sire234/VatPoeToUsb/datasheets/Ag9900_V3.5_2026-03_LPB_SUMMARY.md

# Ag9905-LPB — Silvertel Ag9900-Familie, PoE-PD-Modul 5 V, Low-Profile-SMT (U1)

Quelle: Silvertel Ag9900 Datenblatt **V3.5 (März 2026)**, `Ag9900_V3.5_2026-03_LPB.pdf` (silvertel.com; Text gelesen 2026-10-23). Abbildungs-/Tabellennummern beziehen sich auf V3.5.

| Spec | Wert |
|---|---|
| Norm / Klasse | IEEE 802.3af, Signatur im Modul, **Class 0** (0,44 … 12,95 W) |
| Eingang | 36 … 57 V (typ 48 V); Anlauf ≥ 42 V; UVLO 30 … 36 V; abs. max 60 V, Surge 80 V / 1 ms |
| Ausgang | **5,00 V (4,75 … 5,25 V)**, I_out max **1,4 A** (LP/LPB) |
| Leistung | 7 W; Industrial-Derating **4,5 W @ 85 °C** (Tab. 1, Fig. 10 „LP(B) Operating Profile") |
| Mindestlast | **200 mA** (§2.3.3, §9.3); darunter hörbares Geräusch, MPS-Risiko |
| Regelung | Line 0,01 %, Load 0,08 % |
| Ripple | 120 mVpp (mit Filter A) |
| Wirkungsgrad | 83 % Peak |
| Isolation | **1500 V Impulstest (V_PK)** (§6); Leiterbahnen beidseits der Barriere ≥ 3 mm |
| Temperatur | Industrial −40 … +85 °C, Thermoschutz (reduziert Leistung) |
| Gehäuse LPB (Fig. 18) | 21,21 (max 22,21) × 13,92 (max 14,92) mm, Höhe **8,00 (max 9,20)**; Freihaltung J×K×L 22,81 × 15,52 × 9,20 mm |
| Löten | Reflow J-STD-020, **MSL 1**, **nur Oberseite** (nicht kopfüber durch den Reflow, §8); SMD-Pads (soldermask-defined) bevorzugt |

## Pinout LPB (Tab. 2, 5 Pads)
| Pin | Name | Projekt-Netz |
|-----|---|---|
| 1 | +VDC | +5V_RAW |
| 2 | −VDC | GND |
| 3 | ADJ | AG_ADJ (offen = 5,00 V) |
| 4 | VIN+ | VDD_POE |
| 5 | VIN− | VSS |

(Zum Vergleich LP/DIL, Tab. 3: 1,2 +VDC · 3 −VDC · 4 ADJ · 5,6 VIN+ · 7,8 VIN− – **nicht** pinkompatibel.)

## Externe Beschaltung (Fig. 5, 14, 16)
- BR1/BR2 z. B. MB4S/MB6S → D1/D2 MB6S.
- TVS **SMAJ58A** über VIN (Fig. 14) → D3.
- C1 100 µF low-ESR + C2 10 µF 25 V am Ausgang → C11 100 µF Polymer + C12 22 µF.
- RB ≥ I_load,min (Option) → R8 DNP.
- EMV (Fig. 16): 2 × 4,7 nF / 2 kV Ein-/Ausgang → im Projekt nur C14 2,2 nF Y2 als DNP-Option.
- ADJ (Tab. 4): R ADJ→+VDC senkt (0 Ω → 4,48 V), R ADJ→−VDC hebt (0 Ω → 5,65 V) → R9 DNP nach GND.

## Thermik (§3)
Kupferflächen an +VDC/−VDC auf beiden Aussenlagen mit vielen Vias (Fig. 12); optional Wärmeleitgel > 1,5 W/m·K unter dem Modul (Fig. 13). VIN-Seite nicht an Sekundärkupfer koppeln.

## Land Pattern
Fig. 21 (Reflow, im Projekt verwendet: `Silvertel_Ag9900LPB_SMD`), Fig. 22 (Handlöten: `Silvertel_Ag9900LPB_SMD_HandSolder`), jeweils mit Isolations-Keepout.
