sire234/VatPoeToUsb/datasheets/BLM18PG121SN1D_SUMMARY.md

# BLM18PG121SN1D — Murata Ferrit-Chip-Bead 120 Ω @ 100 MHz, 0603 (FB2)

Quelle: Murata-Katalog Chip-Ferrite-Beads (BLM-Serie), `BLM18PG121SN1D.pdf` (LCSC C14709). Der Katalog-Text ist nur teilweise maschinenlesbar; Werte aus Katalogzeile BLM18PG121SN1 und den JLC/LCSC-Attributen (sourced_bom).

| Spec | Wert |
|---|---|
| Impedanz | 120 Ω ±25 % @ 100 MHz |
| Nennstrom | 2 A |
| DCR | max 0,05 Ω |
| Bauform | 0603 (1,6 × 0,8 mm) |

## Pinout
Unpolarisiert; Pin 1 = +3V3, Pin 2 = +3V3A.

## Hinweise
- Filter +3V3 → +3V3A (W5500-AVDD, MagJack-CT), Last ≈ 0,1 A.
