sire234/VatPoeToUsb/datasheets/HCB3216KF-601T30_SUMMARY.md

# HCB3216KF-601T30 — TAI-TECH High-Current Ferrit-Chip-Bead 600 Ohm @100 MHz, 3 A, 1206

Quelle: TAI-TECH HCB3216KF-601T30, `HCB3216KF-601T30.pdf` (Text gelesen).

| Spec | Value |
|---|---|
| Impedanz | 600 Ohm +-25 % @ 100 MHz (60 mV) |
| DC-Widerstand | 0.04 Ohm max |
| Nennstrom | 3000 mA |
| Abmessungen | 3.20 +-0.20 x 1.60 +-0.20 x 1.10 +-0.20 mm |
| Temperatur | -40..+125 C (Datenblatt-Angabe "-40~+125 / -40~+105") |
| Package | 1206 |

## Pinout
Unpolarisiert, 2 Anschluesse.

## Notes
- DCR 40 mOhm: bei 1.4 A: 56 mV Verlust. Bei hohem DC-Strom faellt die Impedanz (Bias-Derating) - Kurve im Datenblatt (Impedance vs. DC-Bias).
