sire234/VatPoeToUsb/datasheets/SA11AM101A19R15XXX_SUMMARY.md

# SA11AM101A19R15XXX — AISHI Polymer-Aluminium-Kondensator 100 µF 10 V, 7343 (C11)

Quelle: AISHI/Aihua Specification A1-Serie (GRS-DC-1710040, 2017-10-26), `SA11AM101A19R15XXX.pdf` (LCSC C135491, Text gelesen 2026-10-23).

| Spec | Wert |
|---|---|
| Kapazität | 100 µF ±20 % |
| Nennspannung / Surge | 10 V / 11,5 V |
| ESR | max **15 mΩ** (100 kHz) |
| Ripple-Strom | **2500 mA rms** (100 kHz, 20 … 105 °C) |
| Leckstrom | max 200 µA |
| D.F. | max 6 % |
| Temperatur | −55 … +105 °C, Lebensdauer 2000 h @ 105 °C |
| Abmessungen | **7,3 × 4,3 × 1,9 mm** (bestätigt die bisher „unverifizierte" Höhe) |

## Pinout
Gepolt: Pin 1 = + → +5V_RAW, Pin 2 = − → GND. Footprint `Capacitor_Tantalum_SMD:CP_EIA-7343-31_Kemet-D`.

## Hinweise
- Erfüllt die Ag9900-Pflicht „≥ 100 µF low-ESR am Ausgang" (DS V3.5 §2.1), auch bei Kälte.
- Ripple-Rating 2,5 A ≫ Modulausgang 1,4 A.
