sire234/VatPoeToUsb/mechanical/gehaeuse_eckig_rev1/ansicht_druckplatte.png

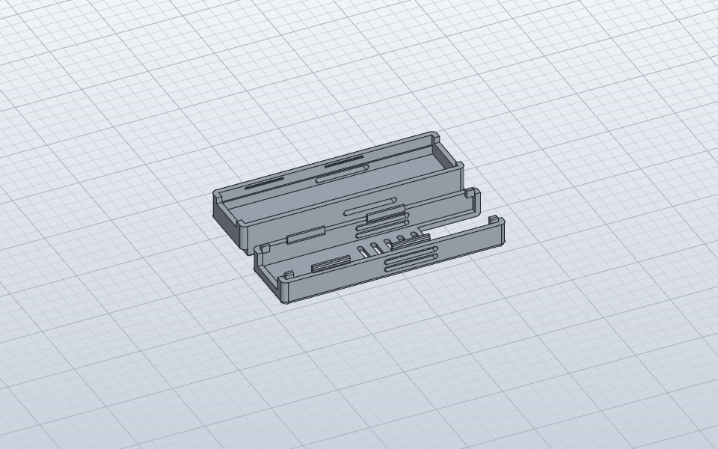
mechanical/gehaeuse_eckig_rev1/ansicht_druckplatte.png
