sire234/VatPoeToUsb/mechanical/gehaeuse_eckig_rev1/ansicht_innen.png

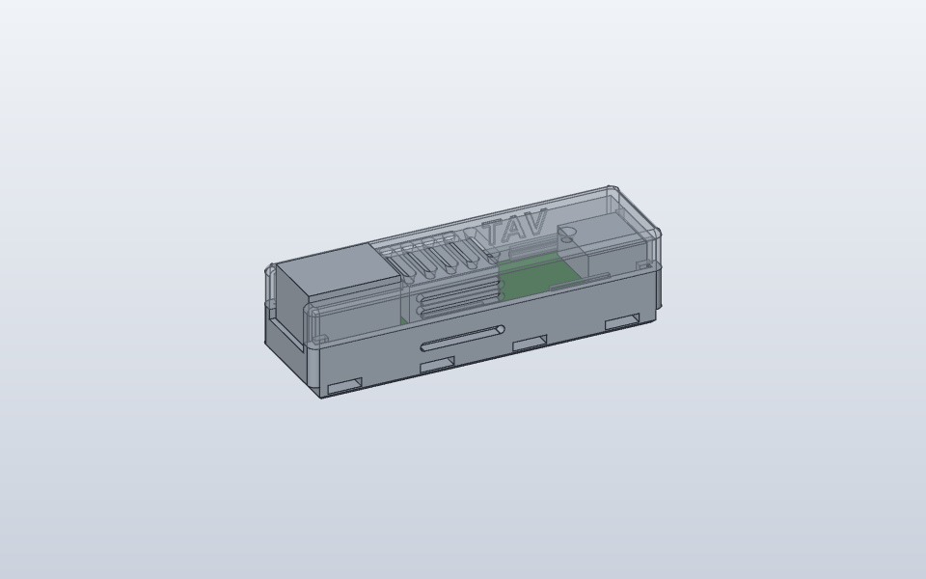
mechanical/gehaeuse_eckig_rev1/ansicht_innen.png
