sire234/VatPoeToUsb/mechanical/gehaeuse_eckig_rev1/ansicht_unten.png

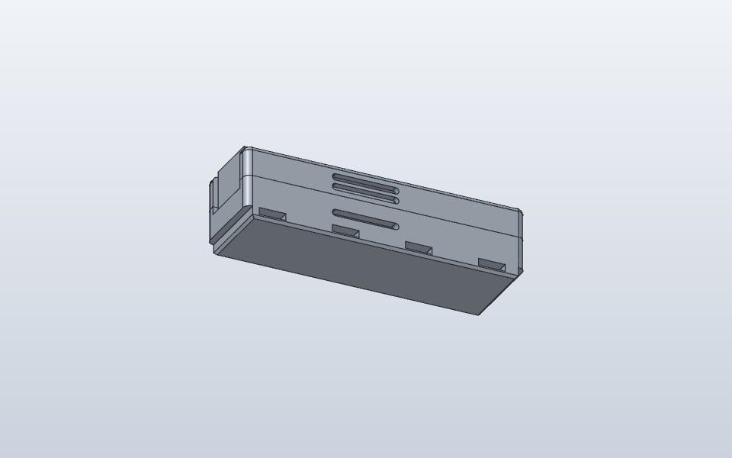
mechanical/gehaeuse_eckig_rev1/ansicht_unten.png
