sire234/VatPoeToUsb/outputs/layout_rev4g/detail_bottom_R5_R6.png

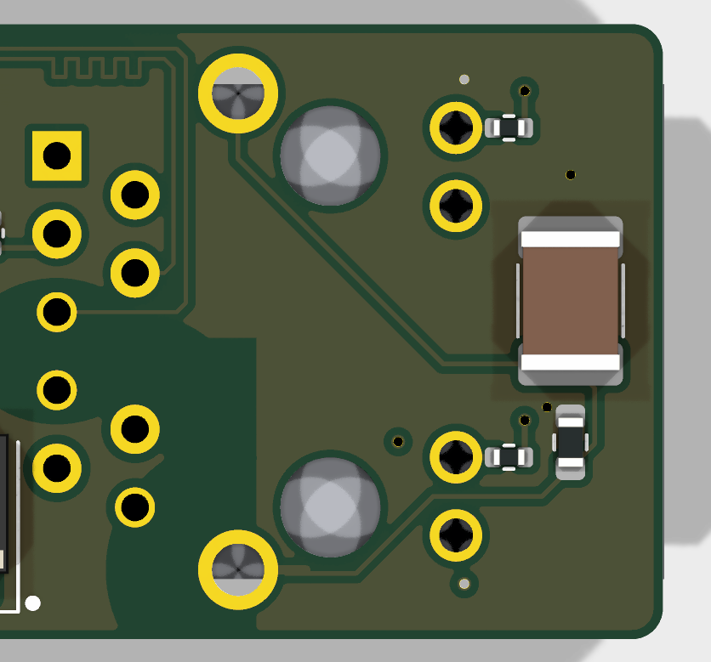
outputs/layout_rev4g/detail_bottom_R5_R6.png
