sire234/VatPoeToUsb/outputs/layout_rev4g/detail_top_pin1_marks.png

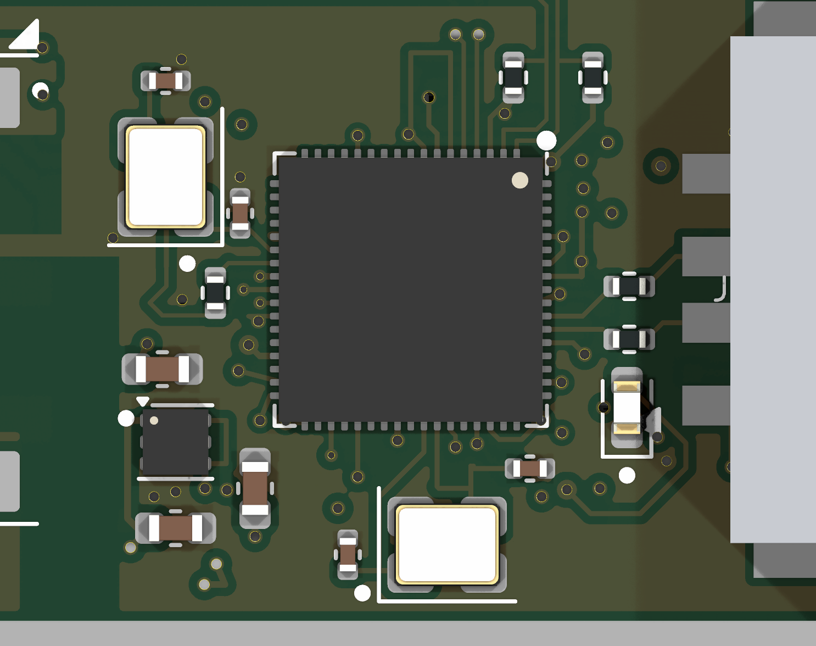
outputs/layout_rev4g/detail_top_pin1_marks.png
