sire234/VatPoeToUsb/outputs/layout_rev4g/render_bottom.png

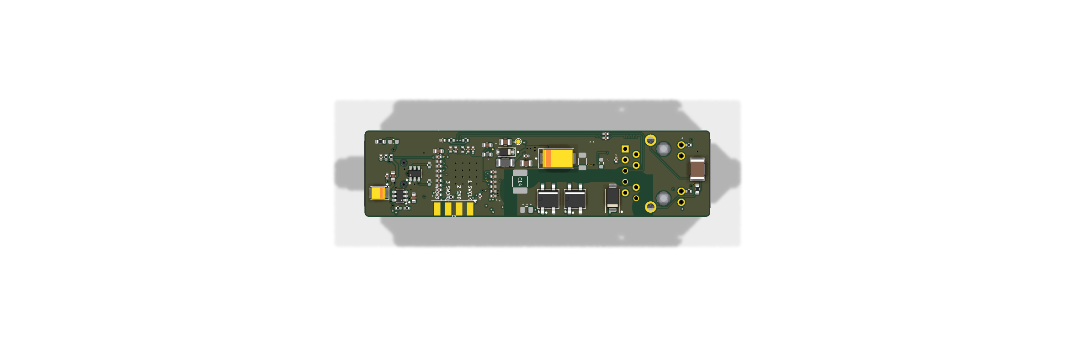
outputs/layout_rev4g/render_bottom.png
