sire234/VatPoeToUsb/outputs/layout_rev4g/render_iso.png

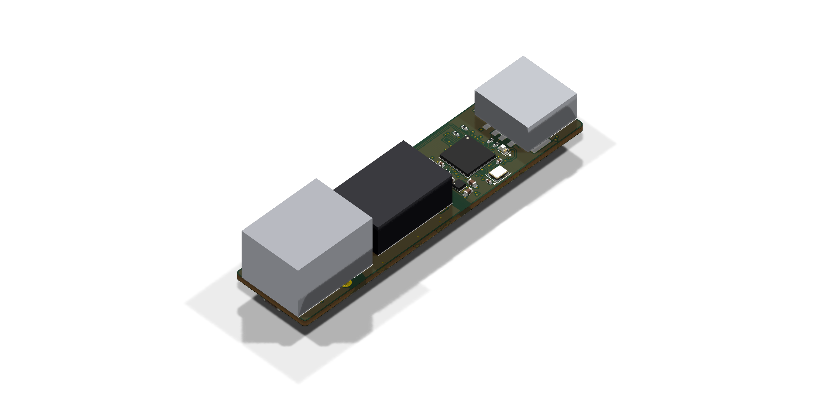
outputs/layout_rev4g/render_iso.png
