sire234/VatPoeToUsb/outputs/layout_rev4g/render_iso_bottom.png

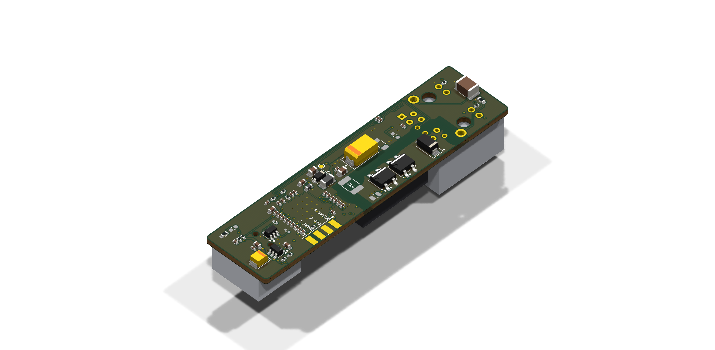
outputs/layout_rev4g/render_iso_bottom.png
