sire234/VatPoeToUsb/outputs/layout_rev4g/render_top.png

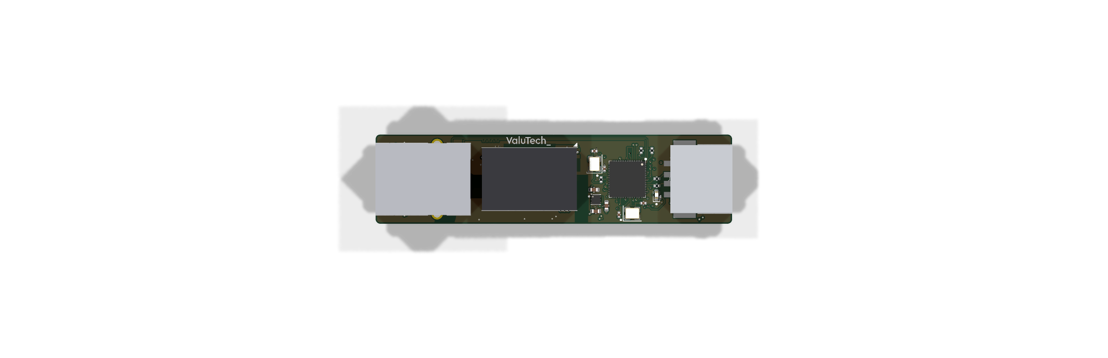
outputs/layout_rev4g/render_top.png
