sire234/VatPoeToUsb/outputs/fab_rev4g_release/poe_usb_hid_bridge_rev4g_BOM_JLC.csv

Comment | Designator | Footprint | LCSC Part #
100nF | C10,C20,C23,C29,C40,C41,C42,C43,C44,C45,C49,C50,C51,C52,C53,C54,C55,C56,C57,C58,C59 | C_0402_1005Metric | C1525
100uF 10V polymer 15mR | C11 | CP_EIA-7343-31_Kemet-D | C135491
22uF 25V X5R | C12 | C_0805_2012Metric | C45783
22uF 25V | C13 | C_0805_2012Metric | C45783
4.7uF | C15,C61 | C_0603_1608Metric | C19666
10uF | C16,C46,C60 | C_0603_1608Metric | C19702
1uF 50V | C17 | C_0603_1608Metric | C15849
150uF 6.3V | C18 | CP_EIA-3528-21_Kemet-B | C212682
10uF 10V | C19 | C_0603_1608Metric | C19702
10nF | C21,C62 | C_0402_1005Metric | C15195
4.7nF 2kV | C24 | C_1812_4532Metric | C106172
15pF | C25,C26 | C_0402_1005Metric | C1548
27pF | C27,C28 | C_0402_1005Metric | C1557
1uF | C47,C48 | C_0402_1005Metric | C52923
6.8nF 50V X7R | C65,C66 | C_0402_1005Metric | C93654
MB6S | D1,D2 | TO-269AA | C2487
SMAJ58A | D3 | D_SMA | C123816
green | D11 | LED_0603_1608Metric | C2962098
BZT52C6V2 | D12 | D_SOD-123 | C271260
600R 3A | FB1 | L_1206_3216Metric | C357023
120R@100MHz | FB2 | L_0603_1608Metric | C14709
HR871150C | J1 | HanRun_HR871150C | C19724786
BX-TYPE-A-MWT4P | J2 | BX-TYPE-A-MWT4P | C18077687
49.9R | R1,R2,R3,R4 | R_0402_1005Metric | C25120
1M | R7 | R_0603_1608Metric | C22935
12.4k | R22 | R_0402_1005Metric | C11692
44.2k | R25 | R_0402_1005Metric | C25895
100k | R26,R32 | R_0402_1005Metric | C25741
27 | R28,R29 | R_0402_1005Metric | C25100
68k | R33 | R_0402_1005Metric | C36871
0R | R34 | R_0603_1608Metric | C21189
1k | R37 | R_0402_1005Metric | C11702
330R | R5,R6,R38 | R_0402_1005Metric | C25104
TLV75733PDRVR | U4 | WSON-6-1EP_2x2mm_P0.65mm_EP1x1.6mm | C2868428
W55RP20 | U5 | W55RP20_QFN-68-1EP_8x8mm_P0.4mm_EP6.2x6.2mm | C43229502
TPS2553DBVR | U6 | SOT-23-6 | C55266
USBLC6-2SC6 | U7 | SOT-23-6 | C7519
12MHz 10pF | Y1 | Crystal_SMD_3225-4Pin_3.2x2.5mm | C20625731
25MHz 18pF | Y2 | Crystal_SMD_3225-4Pin_3.2x2.5mm | C70593
