sire234/VatPoeToUsb/mechanical/gehaeuse_eckig_rev1/A1_wanne.stl

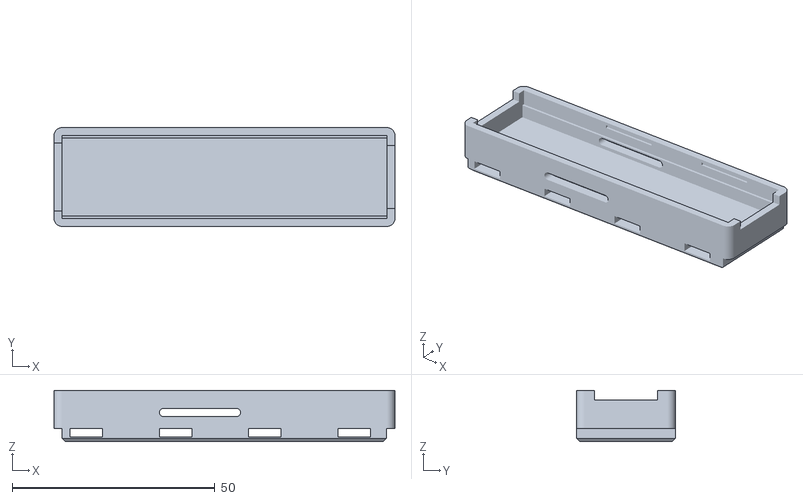
[picture p13: CAD file, 2026-10-30]
mechanical/gehaeuse_eckig_rev1/A1_wanne.stl
84.1 x 24.4 x 12.7
