sire234/VatPoeToUsb/mechanical/gehaeuse_eckig_rev1/gehaeuse_eckig.step

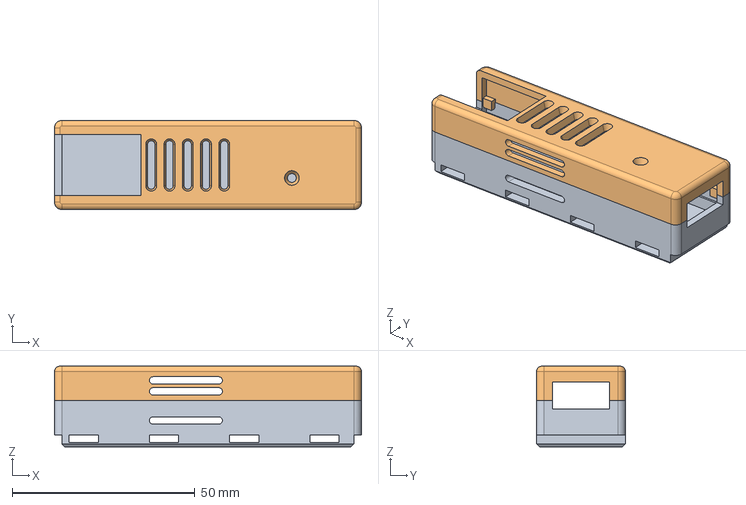
[picture p15: CAD file, 2026-10-30]
mechanical/gehaeuse_eckig_rev1/gehaeuse_eckig.step
84.1 x 24.4 x 22.1 mm
