sire234/VatPoeToUsb/mechanical/gehaeuse_eckig_rev1_swd/A1_deckel_kopfueber.stl

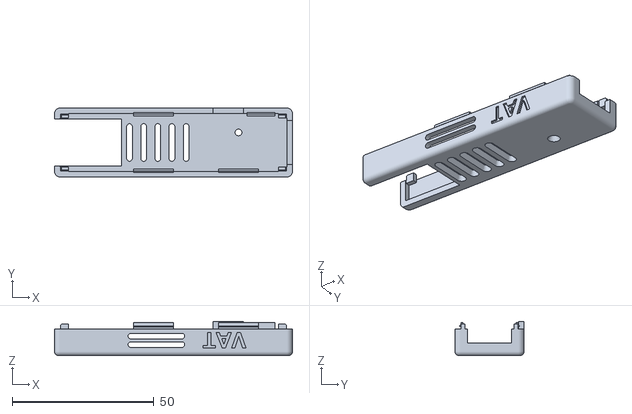
[picture p16: CAD file, 2026-11-12]
mechanical/gehaeuse_eckig_rev1_swd/A1_deckel_kopfueber.stl
84.1 x 24.4 x 12.1
