sire234/VatPoeToUsb/mechanical/gehaeuse_eckig_rev1/A1_eckig_druckplatte.3mf

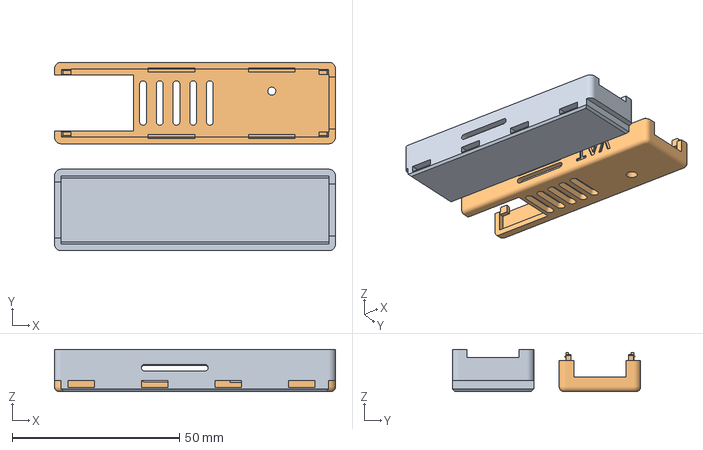
[picture p17: CAD file, 2026-10-30]
mechanical/gehaeuse_eckig_rev1/A1_eckig_druckplatte.3mf
84.1 x 56.4 x 12.7 mm
Druck_Wanne
Druck_Deckel
