sire234/VatPoeToUsb/(list of files, cad)

Other CAD files:
mechanical/gehaeuse_eckig_rev1_swd/gehaeuse_eckig.step
mechanical/gehaeuse_eckig_rev1/A1_deckel_kopfueber.stl
mechanical/gehaeuse_eckig_rev1_swd/A1_eckig_druckplatte.3mf
mechanical/gehaeuse_eckig_rev1/gehaeuse_eckig.3mf
mechanical/gehaeuse_eckig_rev1_swd/gehaeuse_eckig.3mf
