sire234/VatPoeToUsb/outputs/poe_usb_hid_bridge_rev4g_schematic.pdf

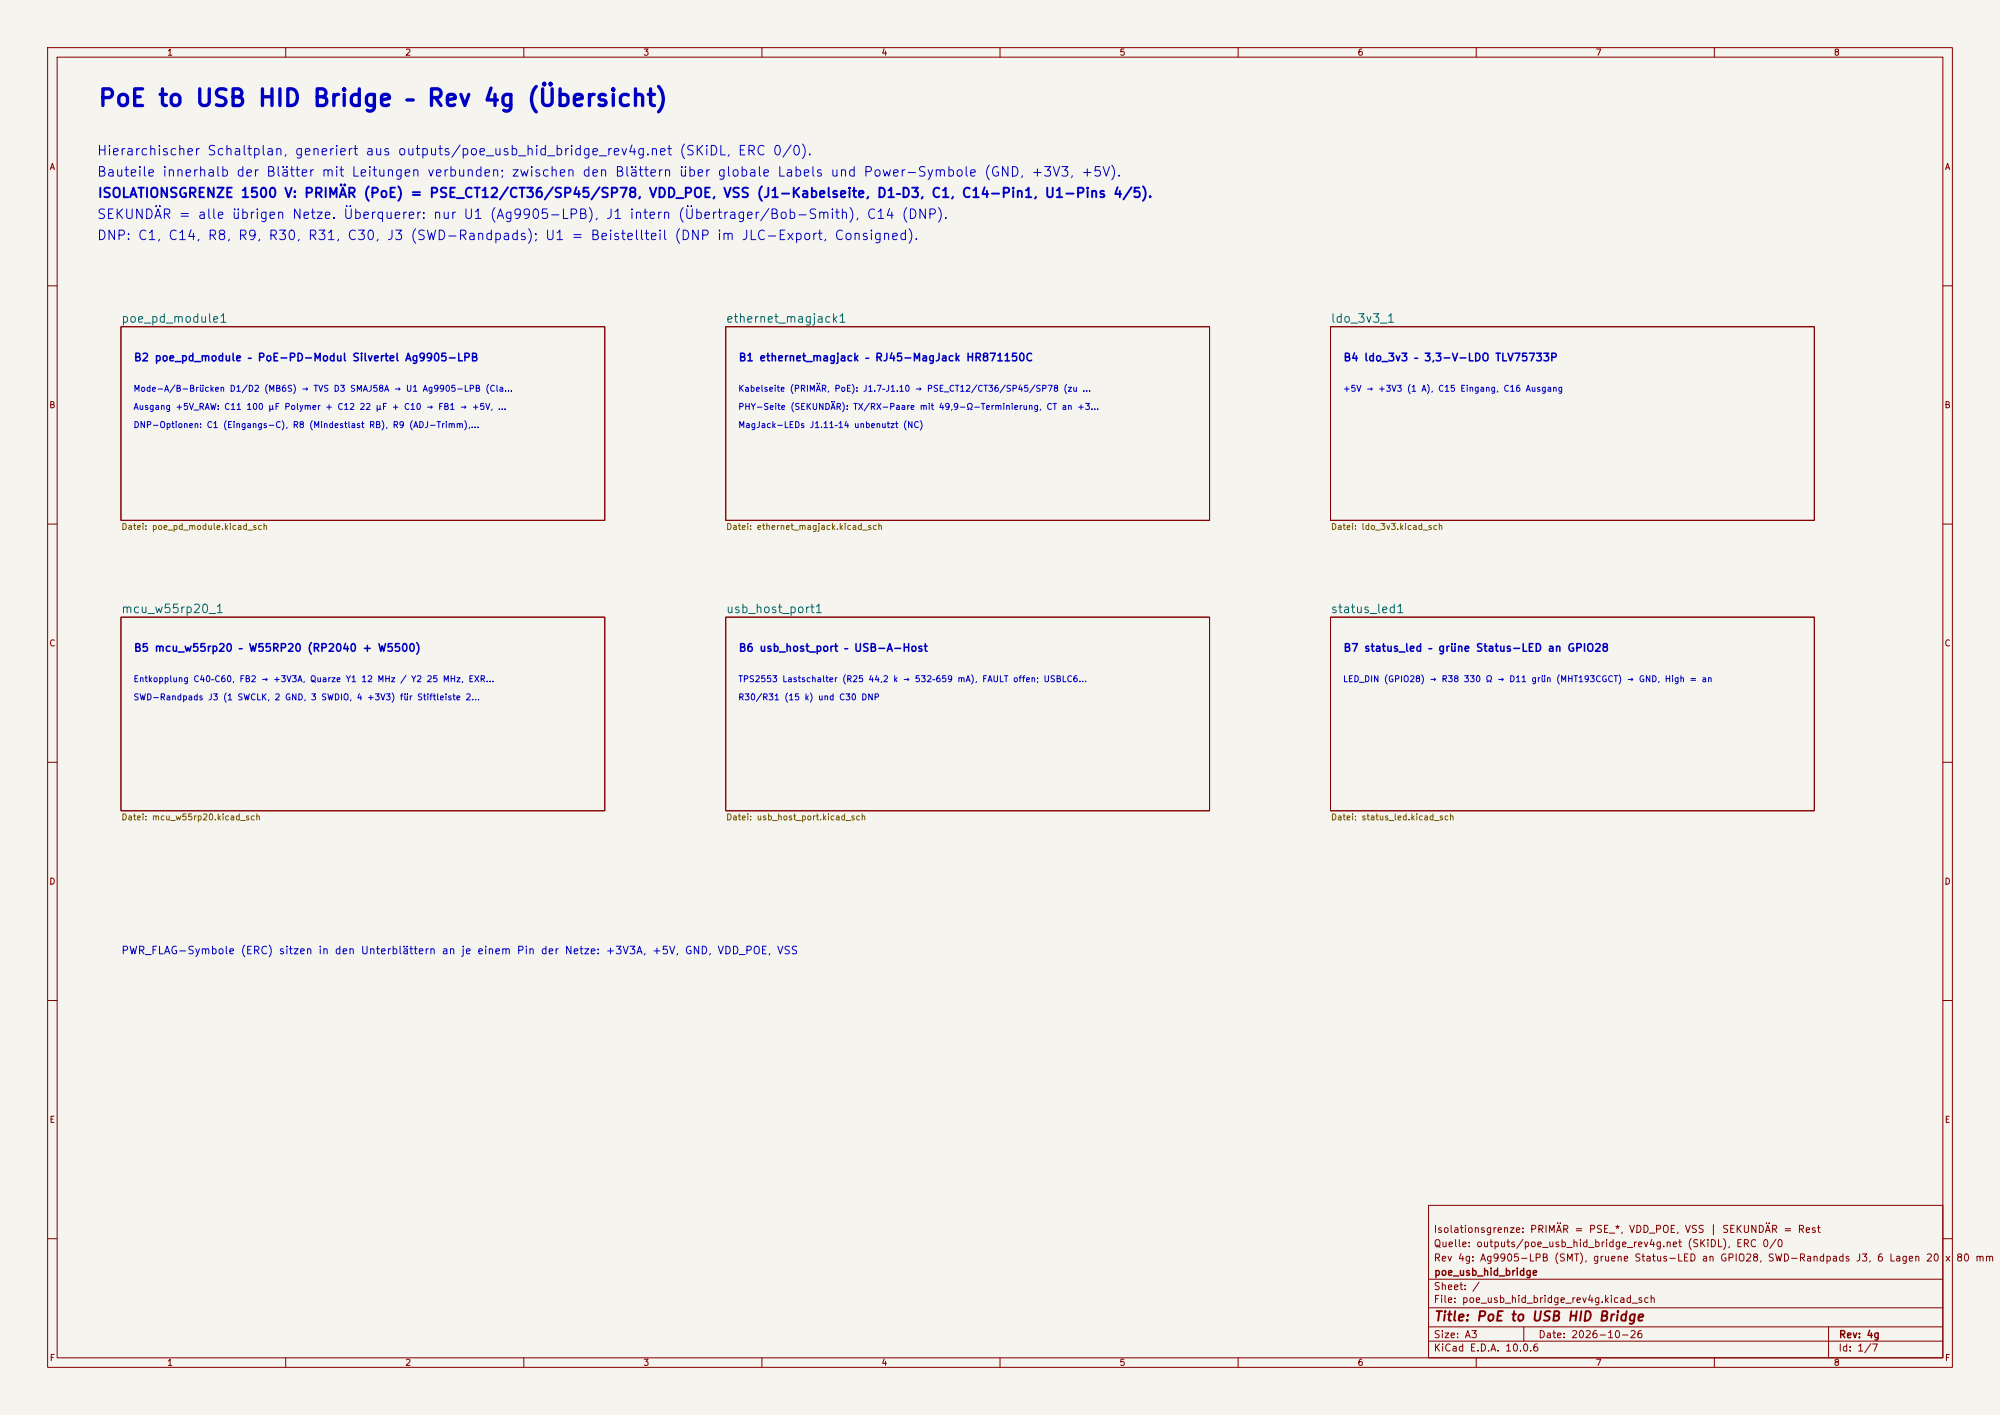
[picture p18: page 1]

PoE to USB HID Bridge – Rev 4g (Übersicht)

Hierarchischer Schaltplan, generiert aus outputs/poe_usb_hid_bridge_rev4g.net (SKiDL, ERC 0/0).
Bauteile innerhalb der Blätter mit Leitungen verbunden; zwischen den Blättern über globale Labels und Power-Symbole (GND, +3V3, +5V).
ISOLATIONSGRENZE 1500 V: PRIMÄR (PoE) = PSE_CT12/CT36/SP45/SP78, VDD_POE, VSS (J1-Kabelseite, D1–D3, C1, C14-Pin1, U1-Pins 4/5).
SEKUNDÄR = alle übrigen Netze. Überquerer: nur U1 (Ag9905-LPB), J1 intern (Übertrager/Bob-Smith), C14 (DNP).
DNP: C1, C14, R8, R9, R30, R31, C30, J3 (SWD-Randpads); U1 = Beistellteil (DNP im JLC-Export, Consigned).

B2 poe_pd_module – PoE-PD-Modul Silvertel Ag9905-LPB

Kabelseite (PRIMÄR, PoE): J1.7–J1.10 → PSE_CT12/CT36/SP45/SP78 (zu …

Mode-A/B-Brücken D1/D2 (MB6S) → TVS D3 SMAJ58A → U1 Ag9905-LPB (Cla…

Ausgang +5V_RAW: C11 100 µF Polymer + C12 22 µF + C10 → FB1 → +5V, …
LED_DIN (GPIO28) → R38 330 Ω → D11 grün (MHT193CGCT) → GND, High = an DNP-Optionen: C1 (Eingangs-C), R8 (Mindestlast RB), R9 (ADJ-Trimm),…

PHY-Seite (SEKUNDÄR): TX/RX-Paare mit 49,9-Ω-Terminierung, CT an +3…

MagJack-LEDs J1.11–14 unbenutzt (NC)

B6 usb_host_port – USB-A-Host TPS2553 Lastschalter (R25 44,2 k → 532–659 mA), FAULT offen; USBLC6…

B7 status_led – grüne Status-LED an GPIO28

Entkopplung C40–C60, FB2 → +3V3A, Quarze Y1 12 MHz / Y2 25 MHz, EXR…

SWD-Randpads J3 (1 SWCLK, 2 GND, 3 SWDIO, 4 +3V3) für Stiftleiste 2…

PWR_FLAG-Symbole (ERC) sitzen in den Unterblättern an je einem Pin der Netze: +3V3A, +5V, GND, VDD_POE, VSS

Isolationsgrenze: PRIMÄR = PSE_*, VDD_POE, VSS | SEKUNDÄR = Rest
Quelle: outputs/poe_usb_hid_bridge_rev4g.net (SKiDL), ERC 0/0
poe_usb_hid_bridge
Sheet: /
File: poe_usb_hid_bridge_rev4g.kicad_sch
Title: PoE to USB HID Bridge

Size: A3 | Rev: 4g | F Date: 2026-10-26
KiCad E.D.A. 10.0.6 | Id: 1/7

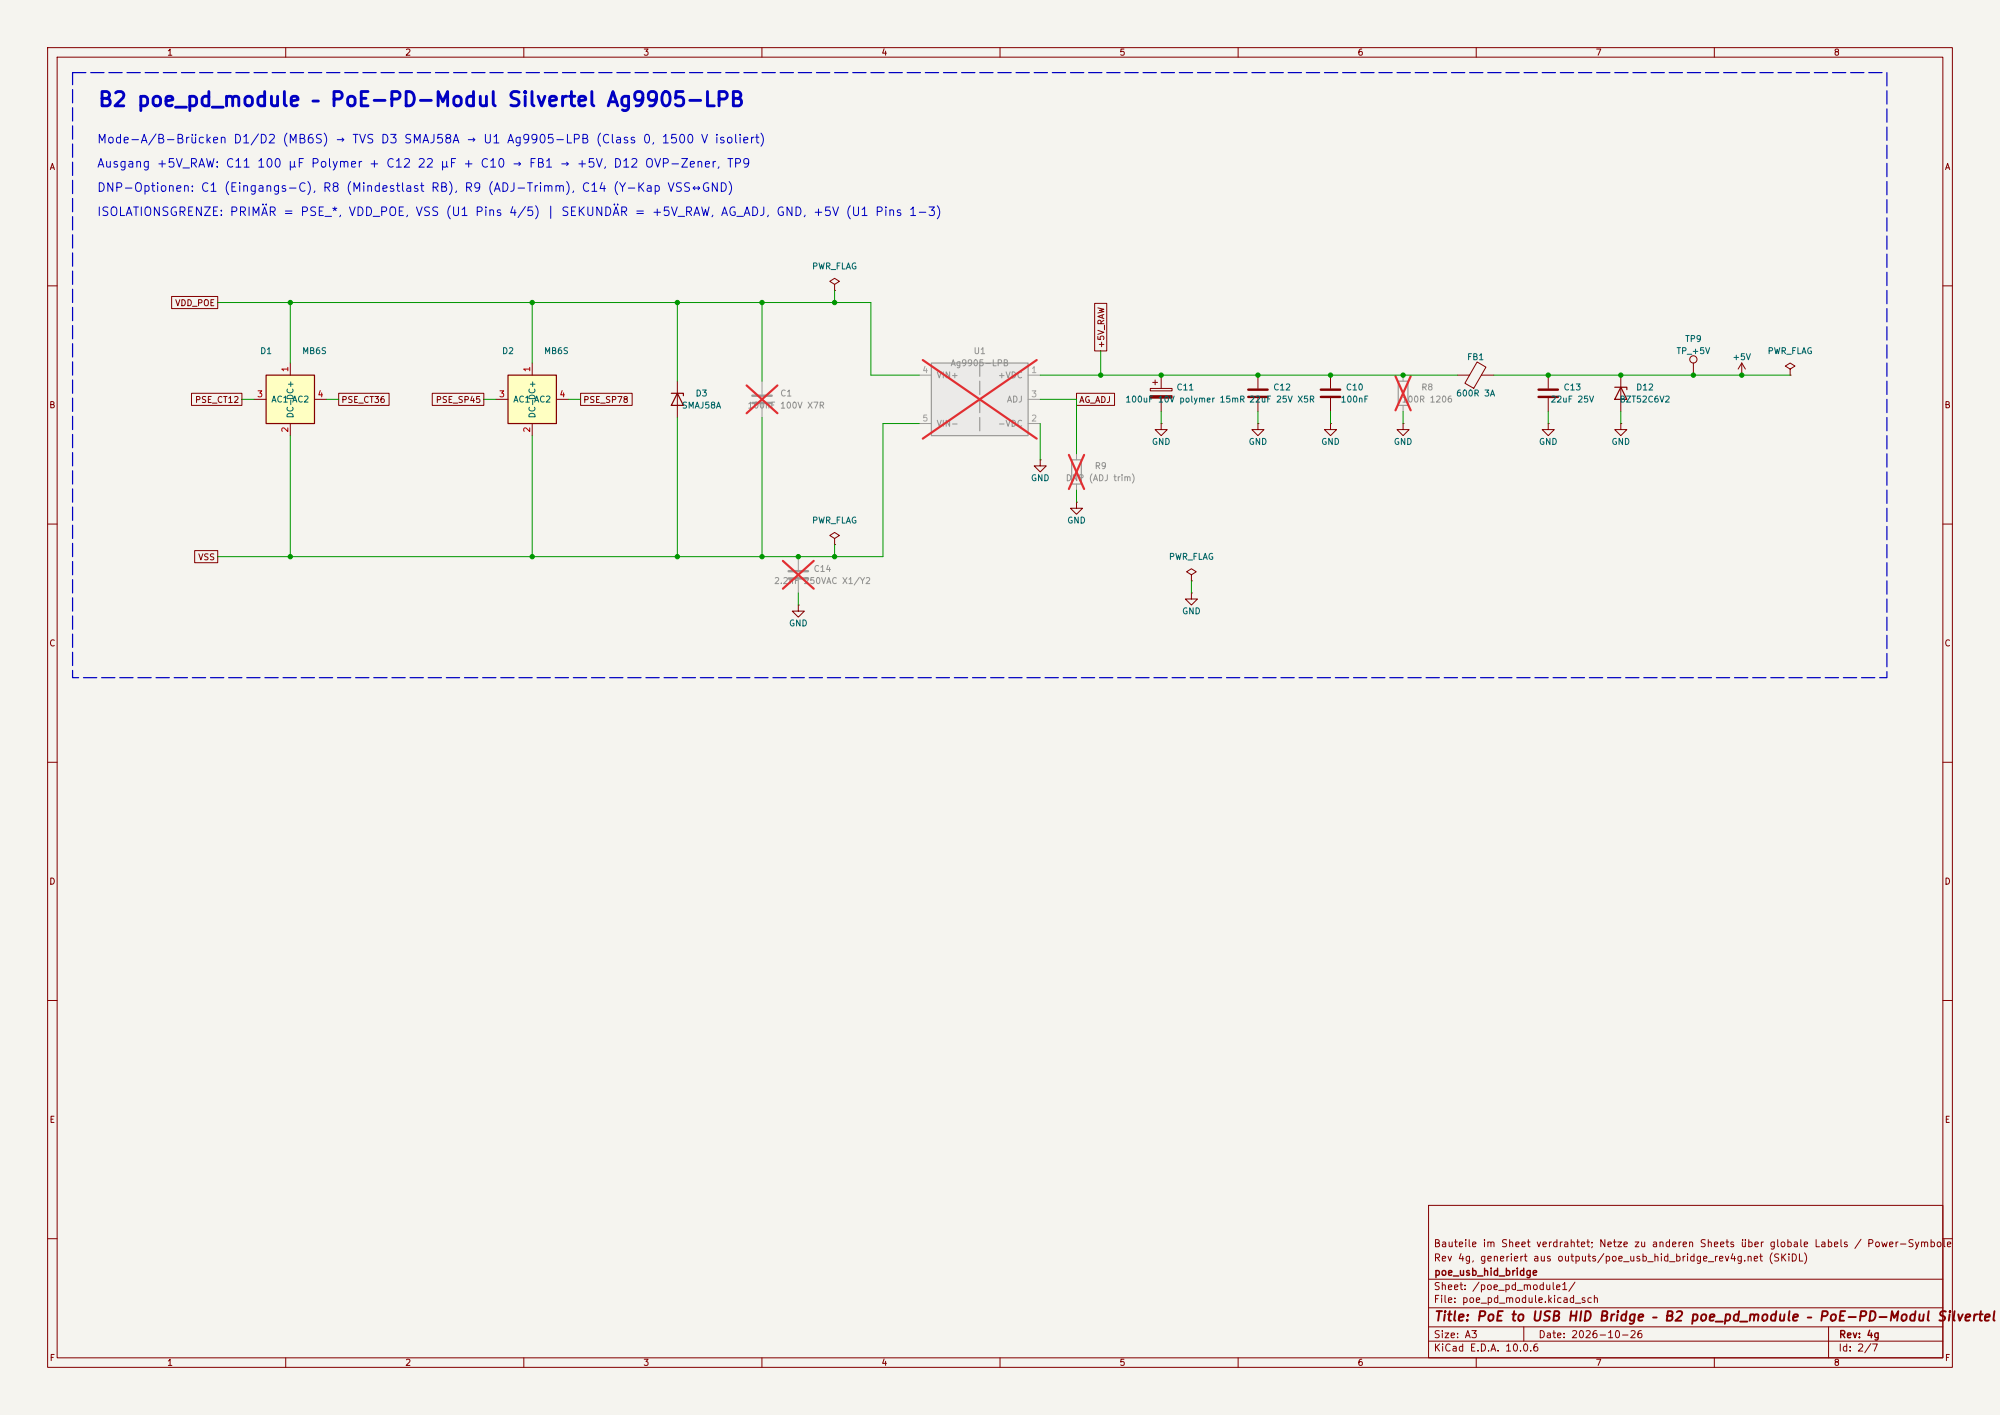
[picture p19: page 2]

Mode-A/B-Brücken D1/D2 (MB6S) → TVS D3 SMAJ58A → U1 Ag9905-LPB (Class 0, 1500 V isoliert)

Ausgang +5V_RAW: C11 100 µF Polymer + C12 22 µF + C10 → FB1 → +5V, D12 OVP-Zener, TP9
DNP-Optionen: C1 (Eingangs-C), R8 (Mindestlast RB), R9 (ADJ-Trimm), C14 (Y-Kap VSS↔GND)
ISOLATIONSGRENZE: PRIMÄR = PSE_*, VDD_POE, VSS (U1 Pins 4/5) | SEKUNDÄR = +5V_RAW, AG_ADJ, GND, +5V (U1 Pins 1-3)

Bauteile im Sheet verdrahtet; Netze zu anderen Sheets über globale Labels / Power-Symbole
Rev 4g, generiert aus outputs/poe_usb_hid_bridge_rev4g.net (SKiDL)
poe_usb_hid_bridge
Sheet: /poe_pd_module1/
File: poe_pd_module.kicad_sch
Title: PoE to USB HID Bridge – B2 poe_pd_module – PoE-PD-Modul Silvertel Ag9905-LPB

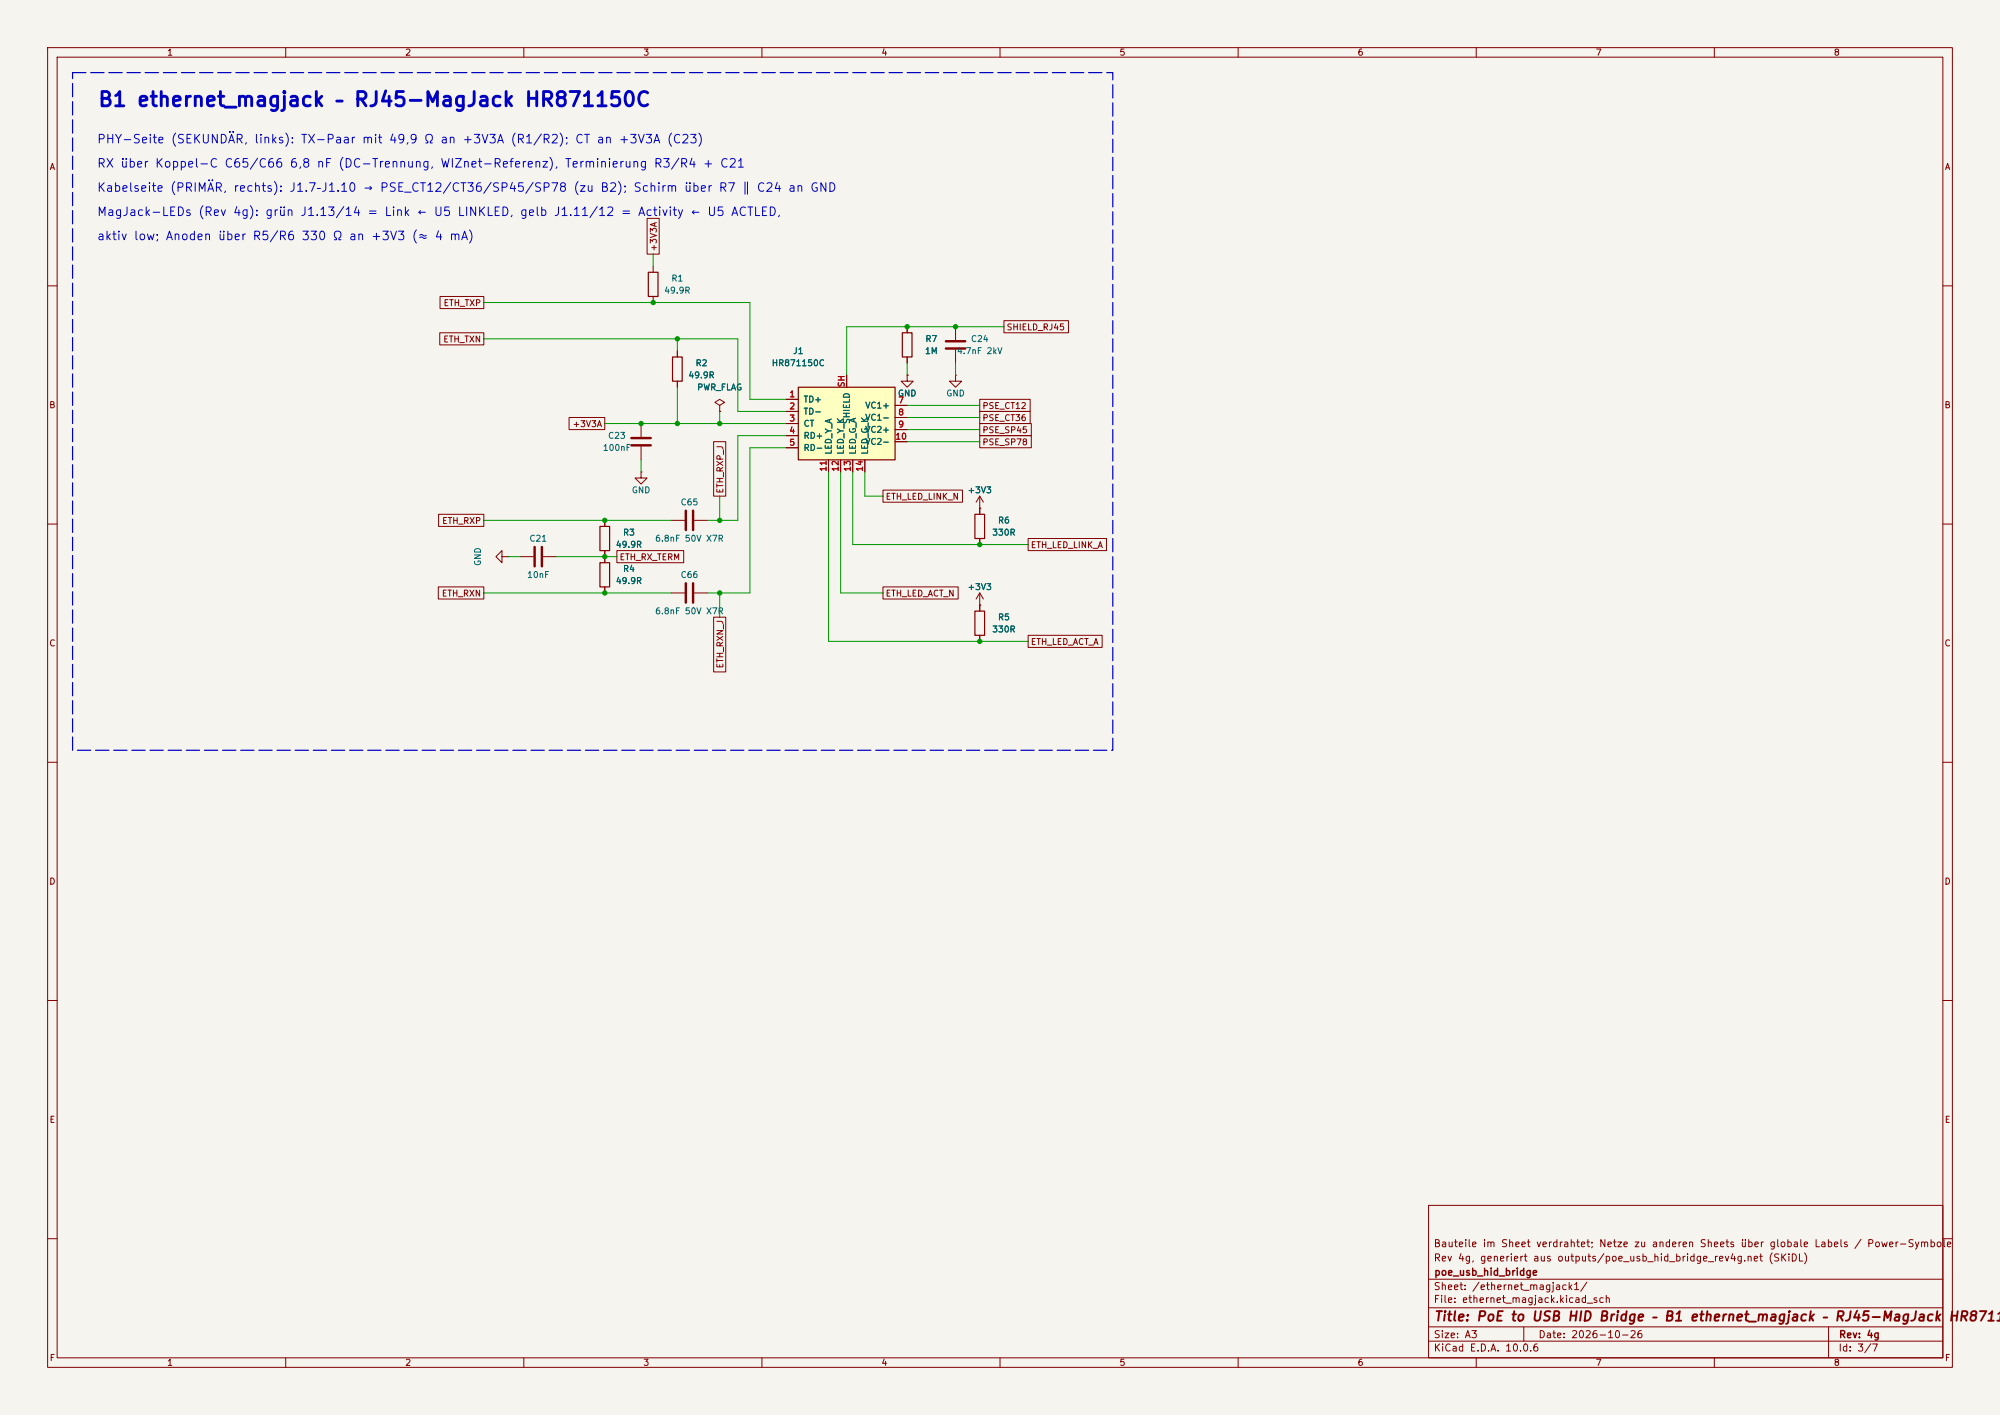
[picture p20: page 3]

RX über Koppel-C C65/C66 6,8 nF (DC-Trennung, WIZnet-Referenz), Terminierung R3/R4 + C21
Kabelseite (PRIMÄR, rechts): J1.7–J1.10 → PSE_CT12/CT36/SP45/SP78 (zu B2); Schirm über R7 ∥ C24 an GND

MagJack-LEDs (Rev 4g): grün J1.13/14 = Link ← U5 LINKLED, gelb J1.11/12 = Activity ← U5 ACTLED,

aktiv low; Anoden über R5/R6 330 Ω an +3V3 (≈ 4 mA)

Bauteile im Sheet verdrahtet; Netze zu anderen Sheets über globale Labels / Power-Symbole
Rev 4g, generiert aus outputs/poe_usb_hid_bridge_rev4g.net (SKiDL)
poe_usb_hid_bridge
Sheet: /ethernet_magjack1/
File: ethernet_magjack.kicad_sch
Title: PoE to USB HID Bridge – B1 ethernet_magjack – RJ45-MagJack HR871150C

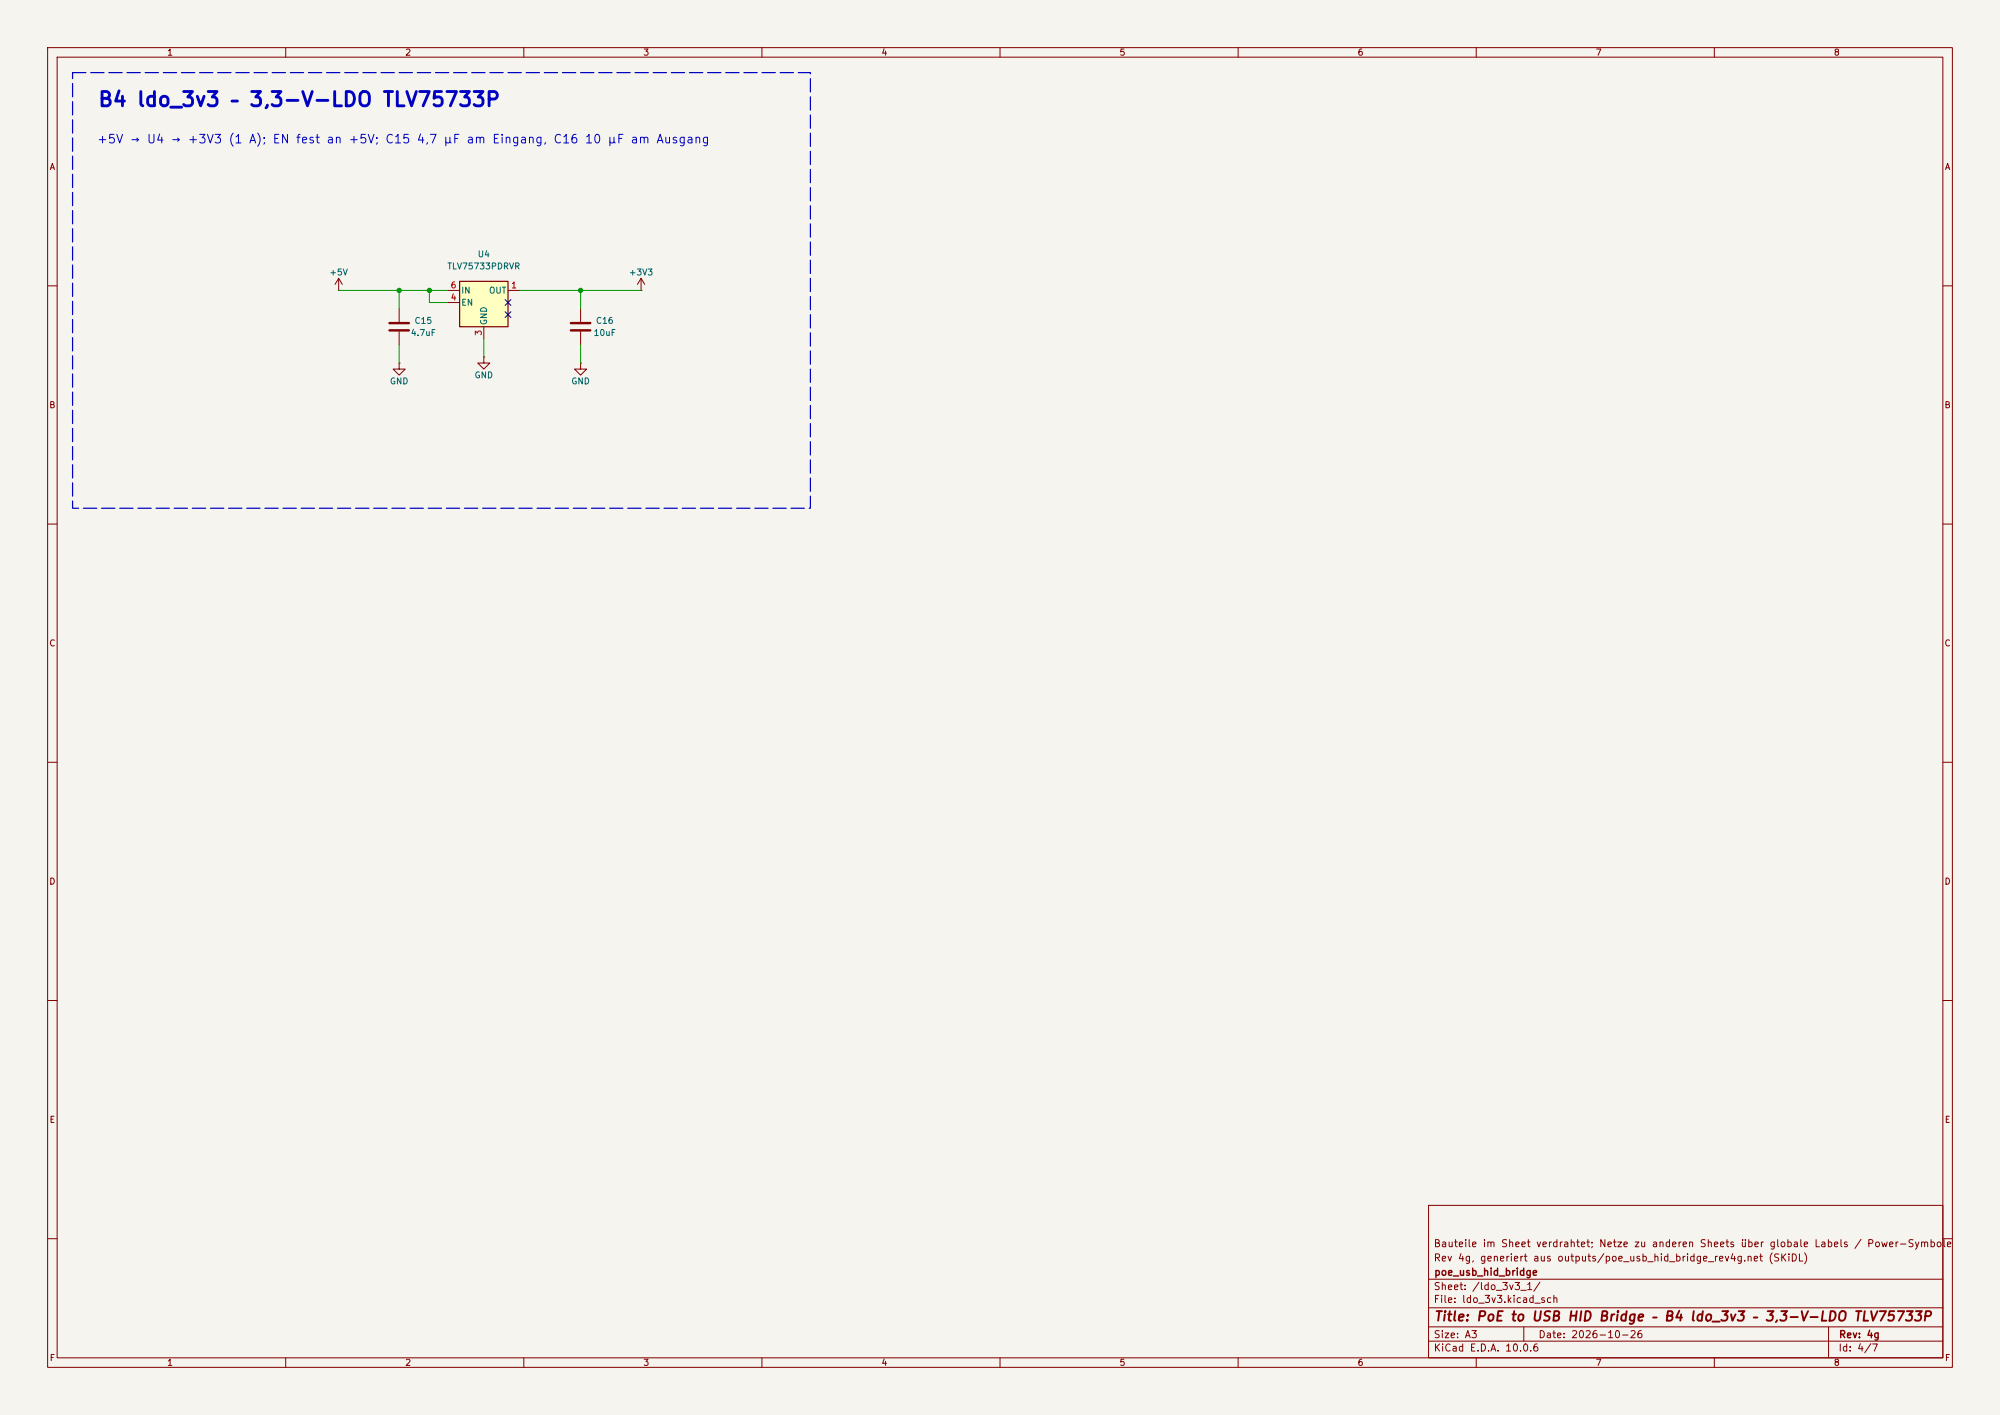
[picture p21: page 4]

+5V → U4 → +3V3 (1 A); EN fest an +5V; C15 4,7 µF am Eingang, C16 10 µF am Ausgang

Bauteile im Sheet verdrahtet; Netze zu anderen Sheets über globale Labels / Power-Symbole
Rev 4g, generiert aus outputs/poe_usb_hid_bridge_rev4g.net (SKiDL)
poe_usb_hid_bridge
Sheet: /ldo_3v3_1/
File: ldo_3v3.kicad_sch
Title: PoE to USB HID Bridge – B4 ldo_3v3 – 3,3-V-LDO TLV75733P

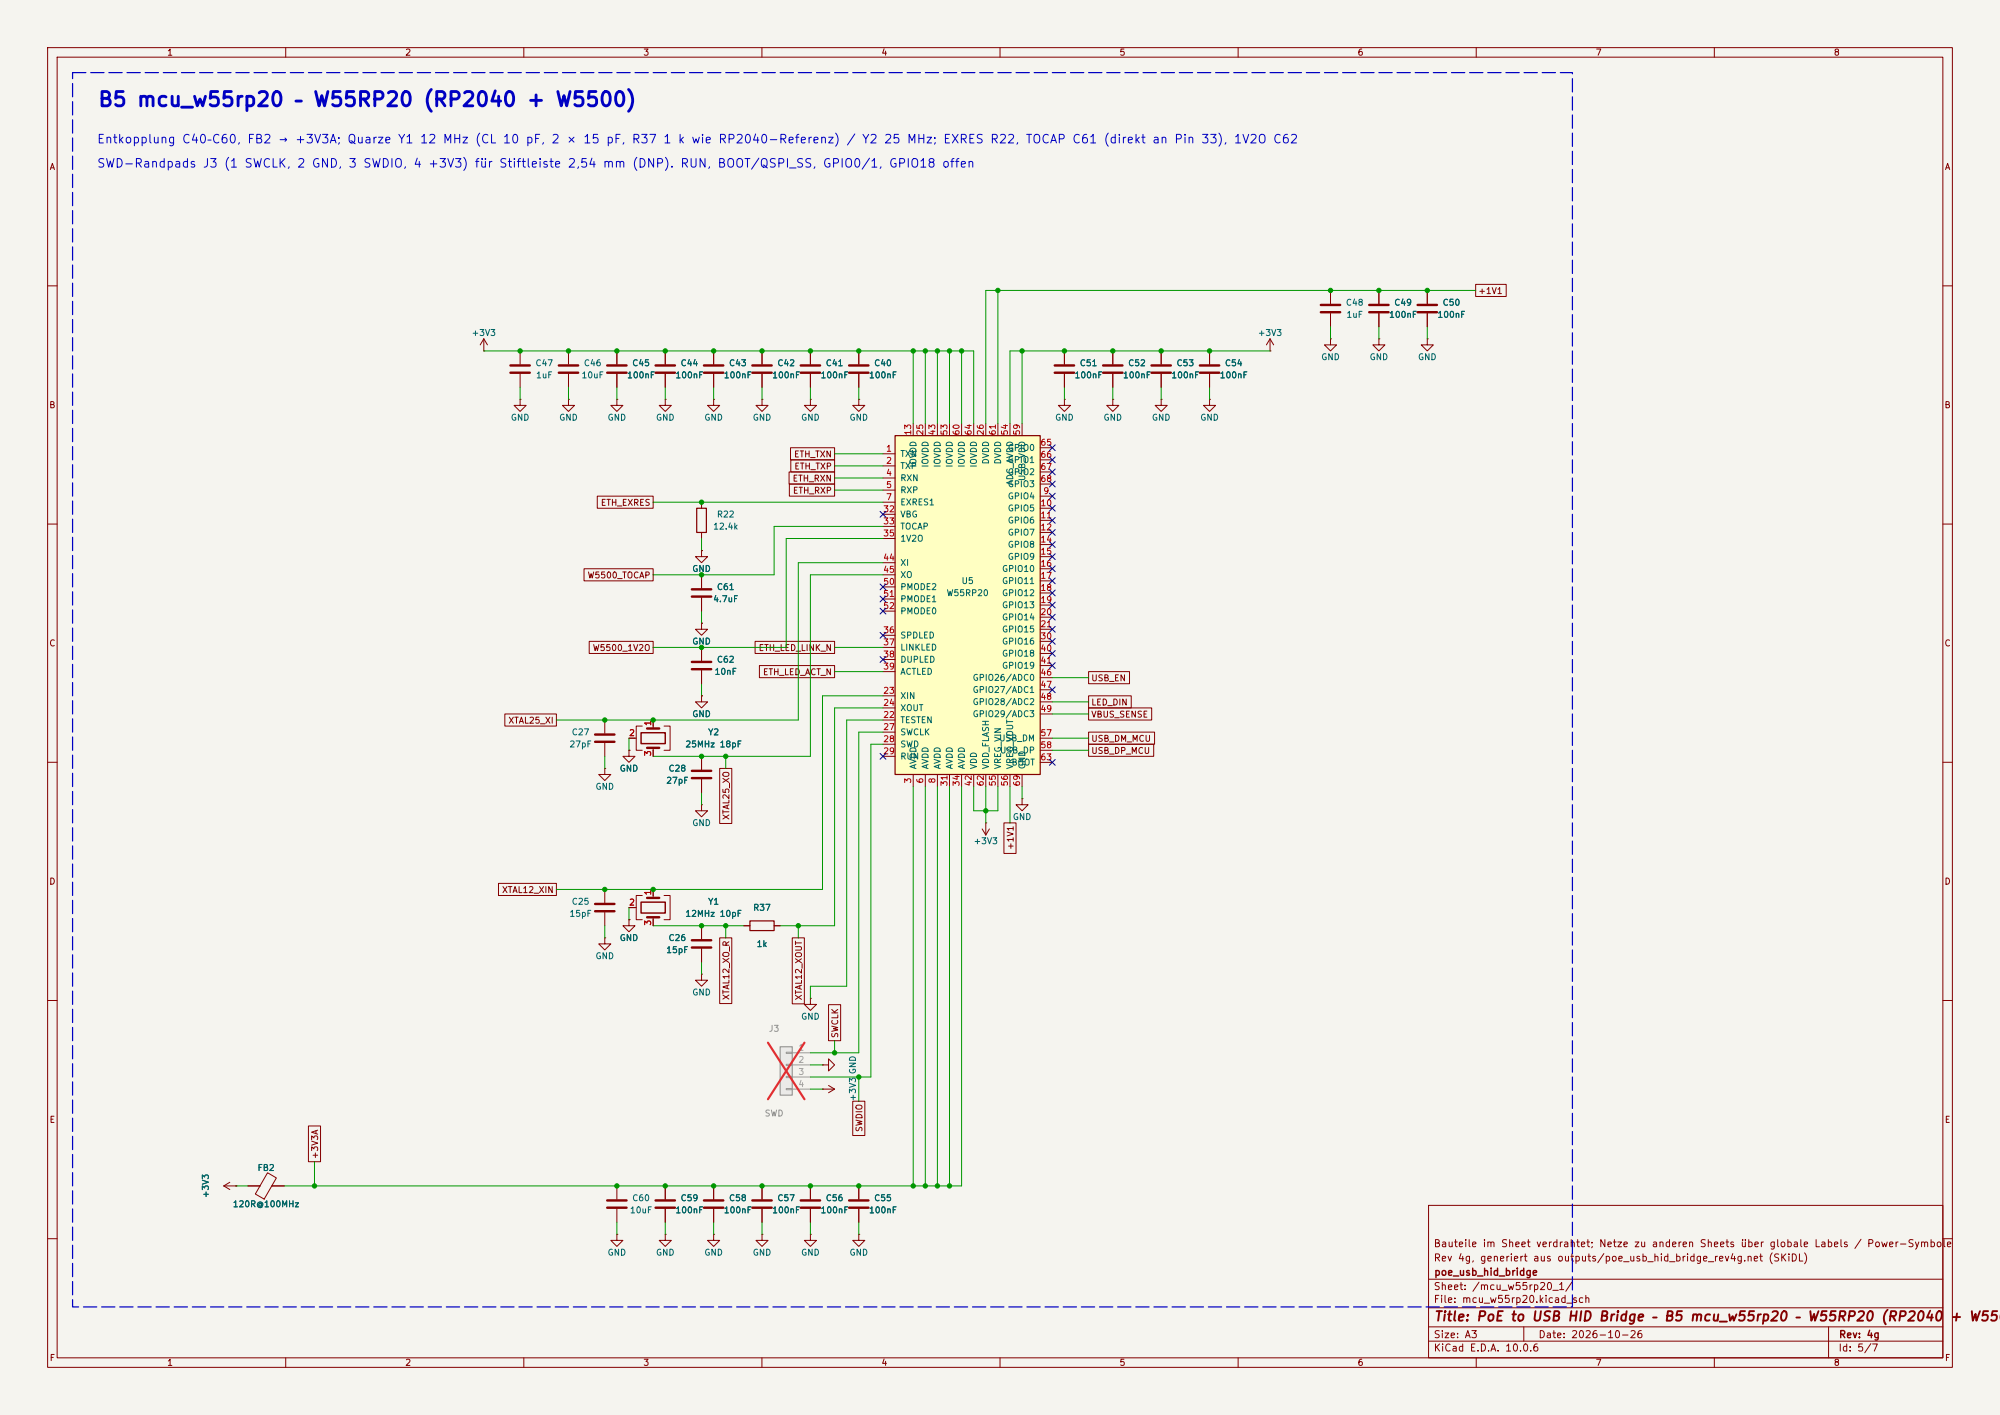
[picture p22: page 5]

Entkopplung C40–C60, FB2 → +3V3A; Quarze Y1 12 MHz (CL 10 pF, 2 × 15 pF, R37 1 k wie RP2040-Referenz) / Y2 25 MHz; EXRES R22, TOCAP C61 (direkt an Pin 33), 1V2O C62

SWD-Randpads J3 (1 SWCLK, 2 GND, 3 SWDIO, 4 +3V3) für Stiftleiste 2,54 mm (DNP). RUN, BOOT/QSPI_SS, GPIO0/1, GPIO18 offen

Bauteile im Sheet verdrahtet; Netze zu anderen Sheets über globale Labels / Power-Symbole
Rev 4g, generiert aus outputs/poe_usb_hid_bridge_rev4g.net (SKiDL)
poe_usb_hid_bridge
Sheet: /mcu_w55rp20_1/
File: mcu_w55rp20.kicad_sch
Title: PoE to USB HID Bridge – B5 mcu_w55rp20 – W55RP20 (RP2040 + W5500)

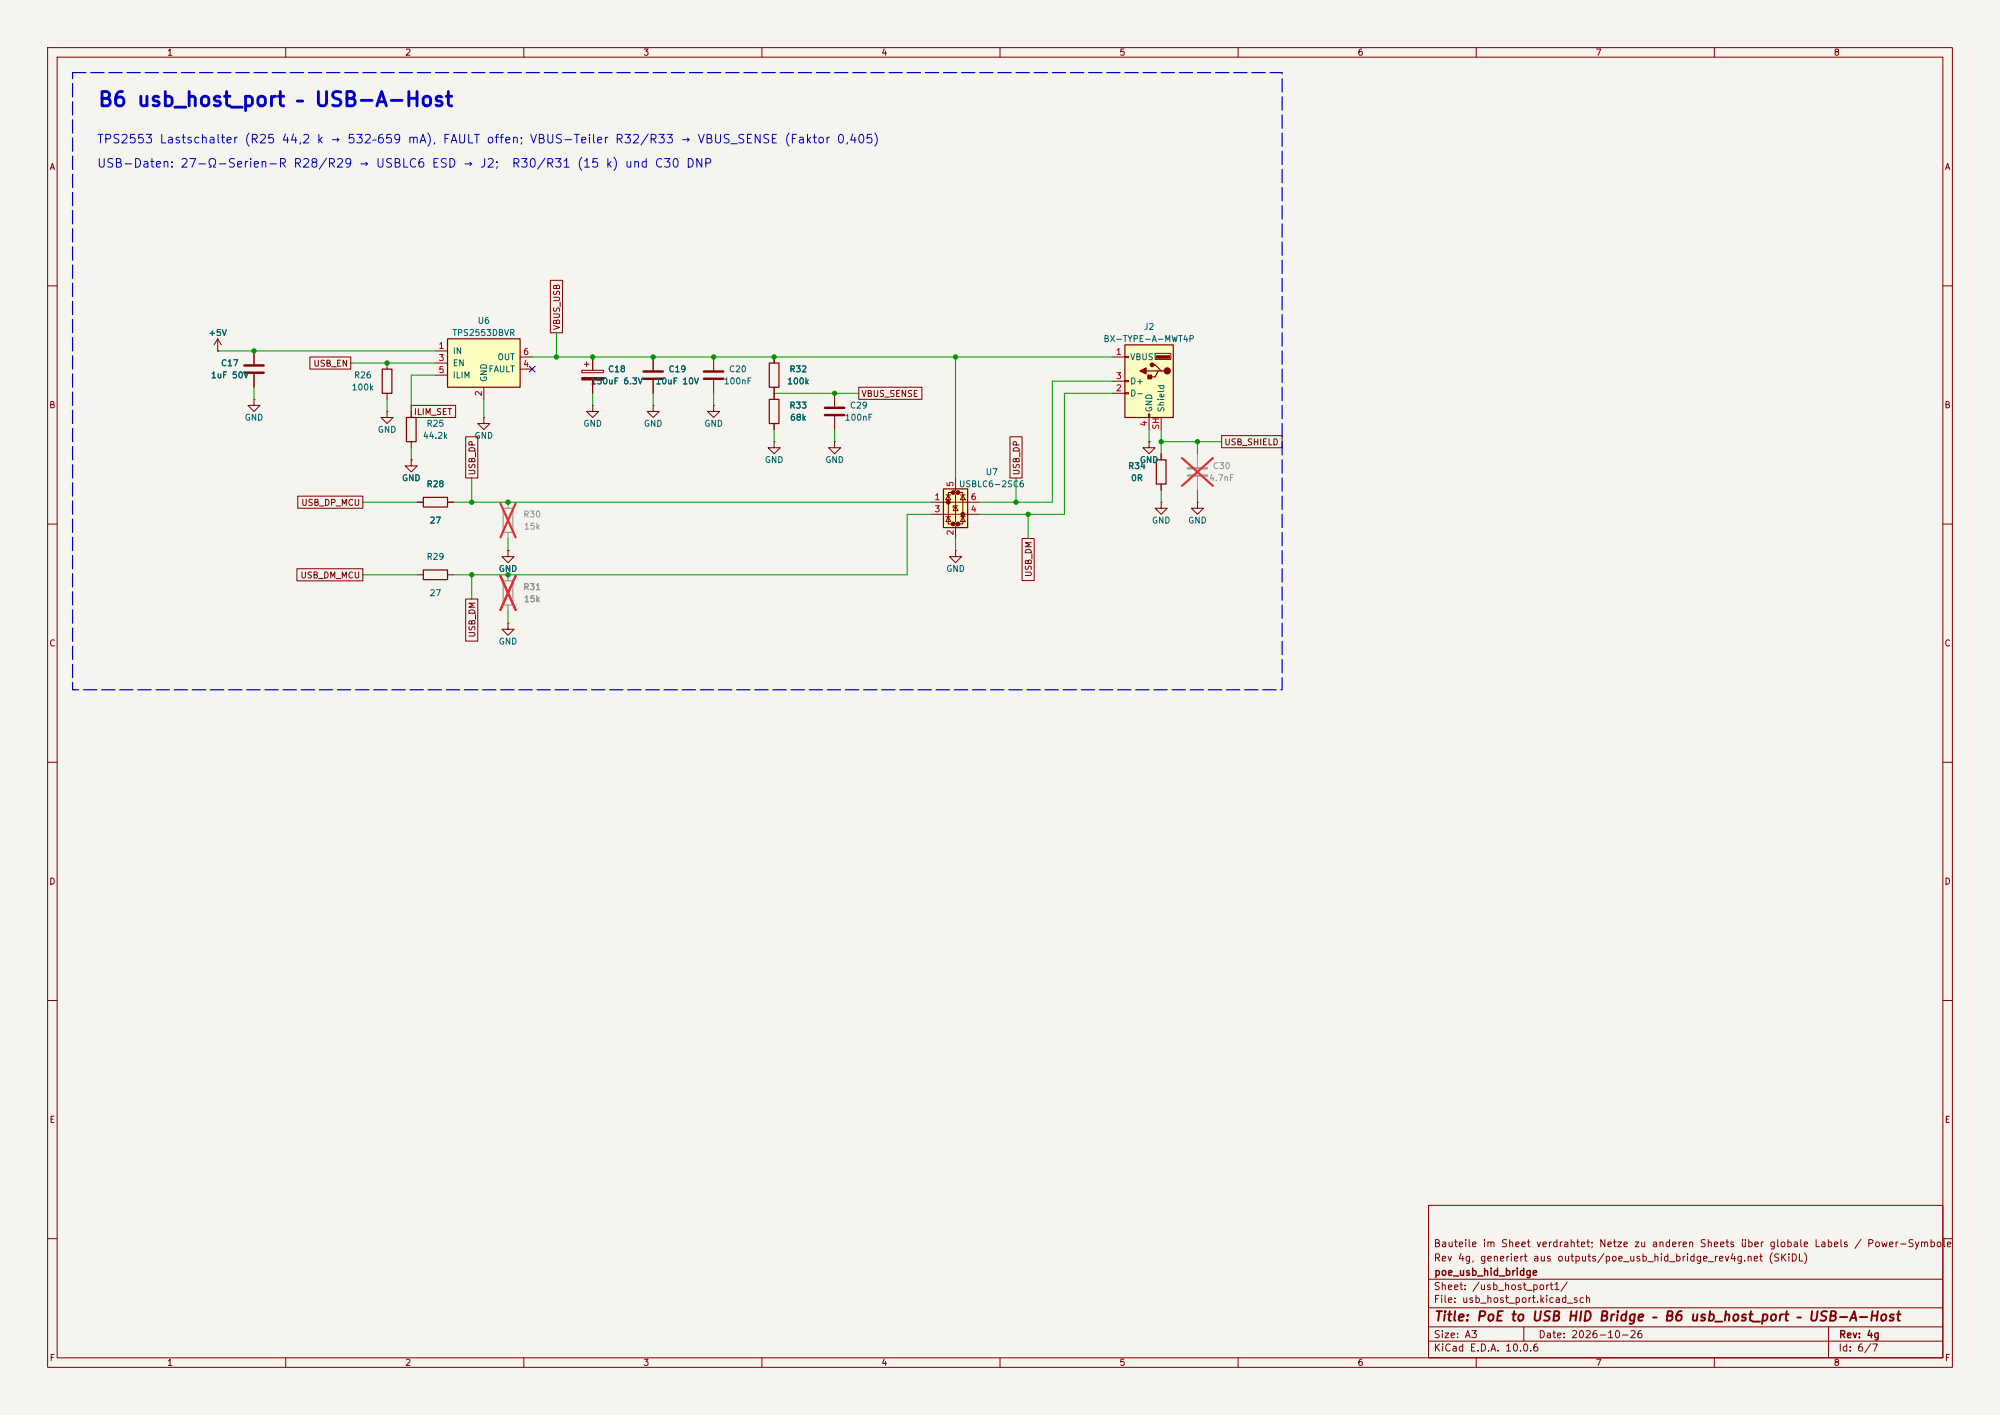
[picture p23: page 6]

USB_SHIELD TPS2553 Lastschalter (R25 44,2 k → 532–659 mA), FAULT offen; VBUS-Teiler R32/R33 → VBUS_SENSE (Faktor 0,405)

Bauteile im Sheet verdrahtet; Netze zu anderen Sheets über globale Labels / Power-Symbole
Rev 4g, generiert aus outputs/poe_usb_hid_bridge_rev4g.net (SKiDL)
poe_usb_hid_bridge
Sheet: /usb_host_port1/
File: usb_host_port.kicad_sch
Title: PoE to USB HID Bridge – B6 usb_host_port – USB-A-Host

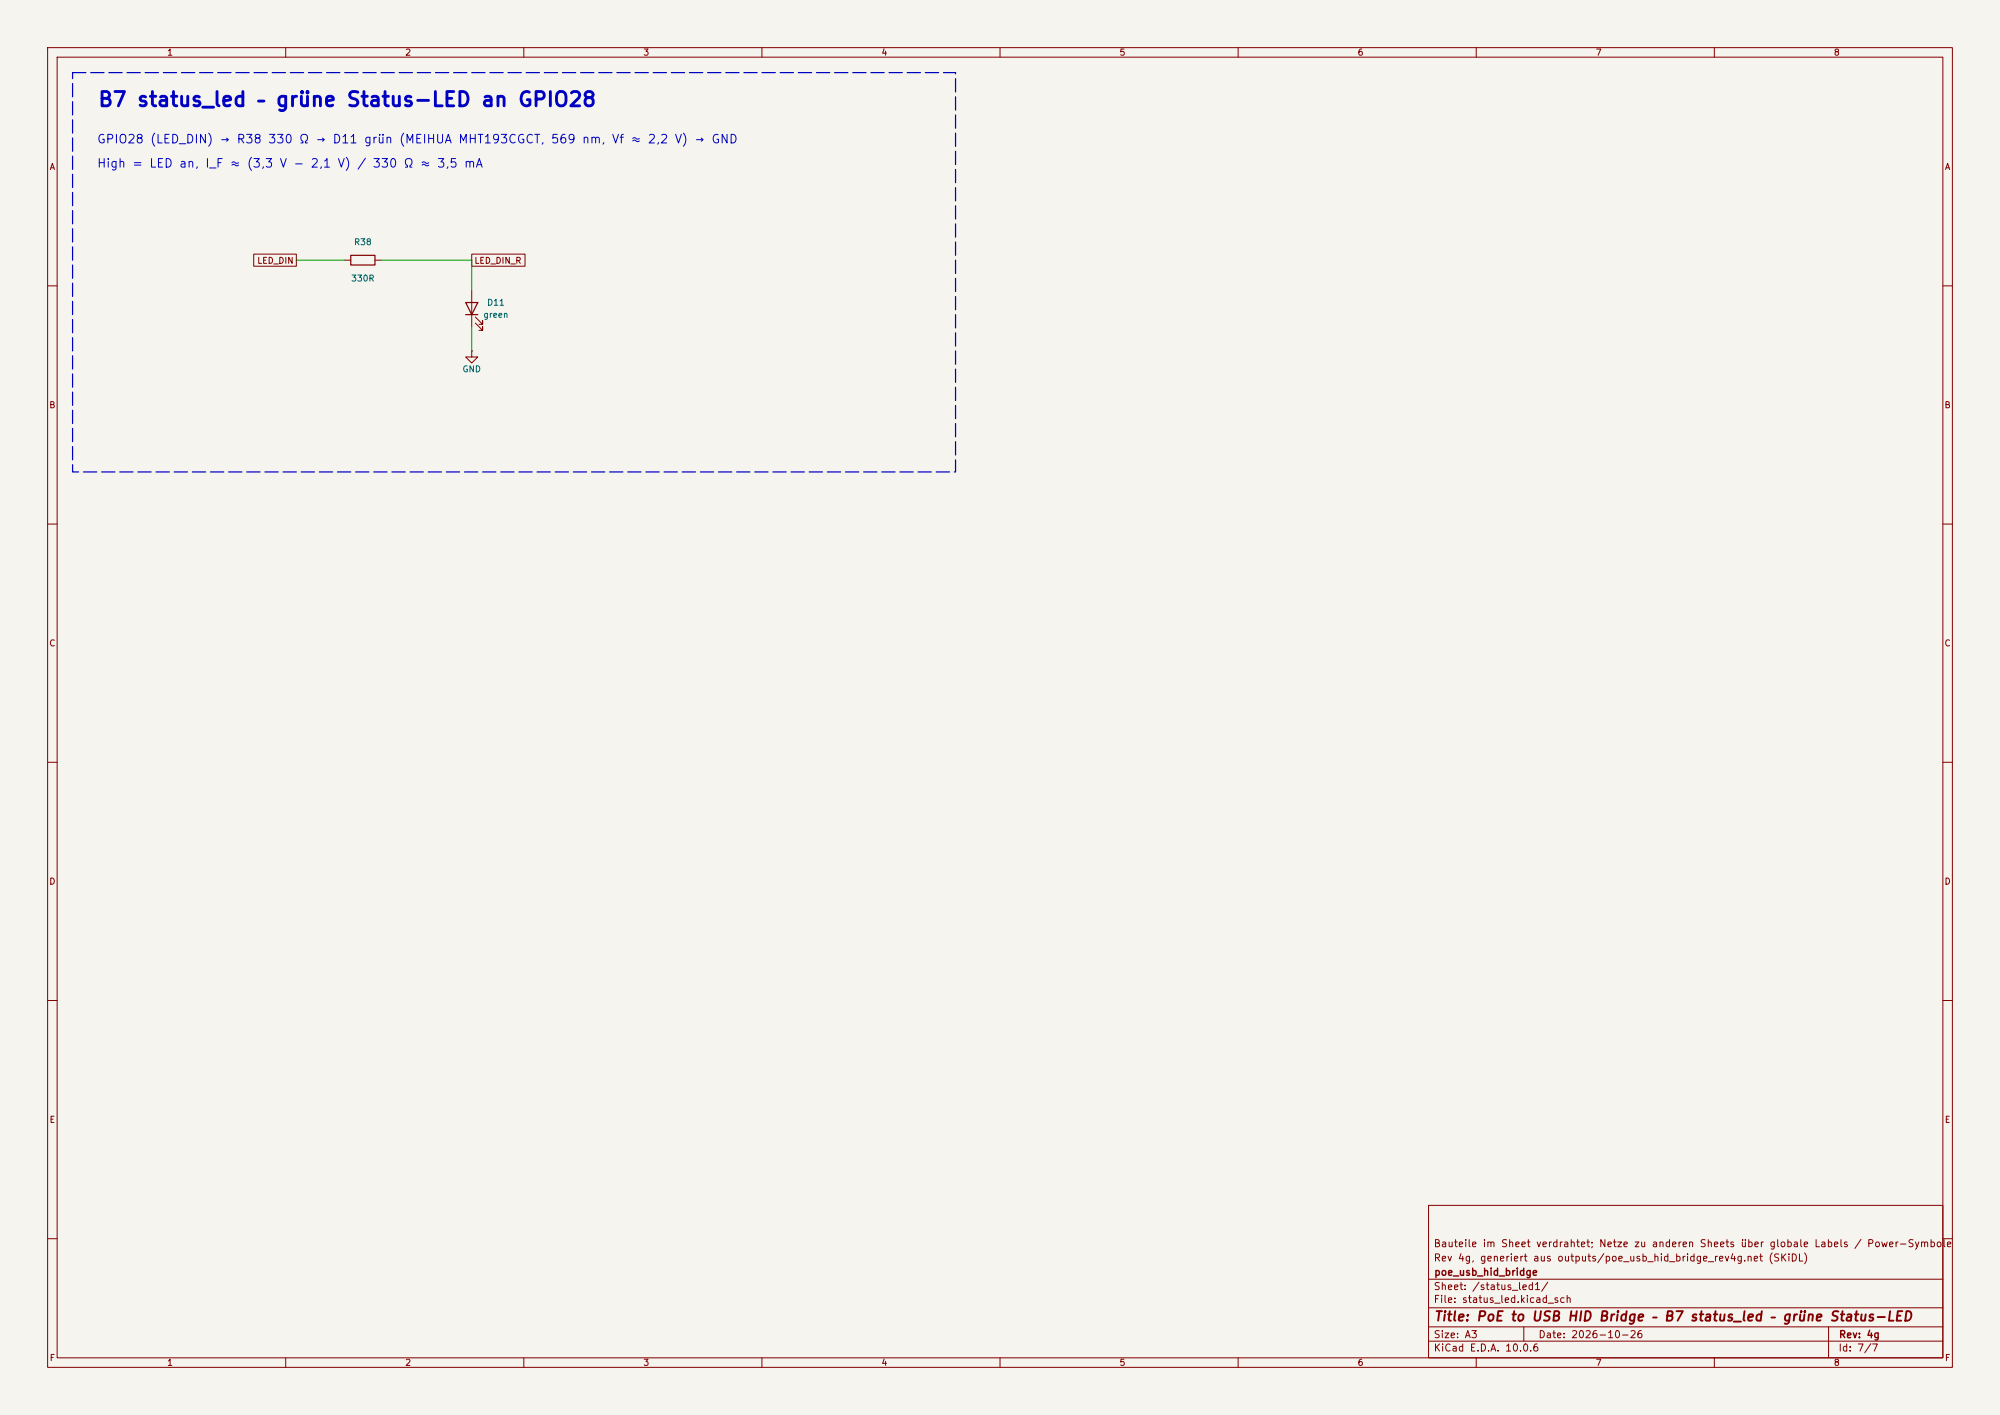
[picture p24: page 7]

GPIO28 (LED_DIN) → R38 330 Ω → D11 grün (MEIHUA MHT193CGCT, 569 nm, Vf ≈ 2,2 V) → GND

High = LED an, I_F ≈ (3,3 V − 2,1 V) / 330 Ω ≈ 3,5 mA

Bauteile im Sheet verdrahtet; Netze zu anderen Sheets über globale Labels / Power-Symbole
Rev 4g, generiert aus outputs/poe_usb_hid_bridge_rev4g.net (SKiDL)
poe_usb_hid_bridge
Sheet: /status_led1/
File: status_led.kicad_sch
Title: PoE to USB HID Bridge – B7 status_led – grüne Status-LED
