sire234/VatPoeToUsb/kicad/poe_usb_hid_bridge_rev4g/poe_usb_hid_bridge_rev4g.kicad_pcb

## KiCad design kicad/poe_usb_hid_bridge_rev4g/poe_usb_hid_bridge_rev4g.kicad_pcb (2026-10-26)

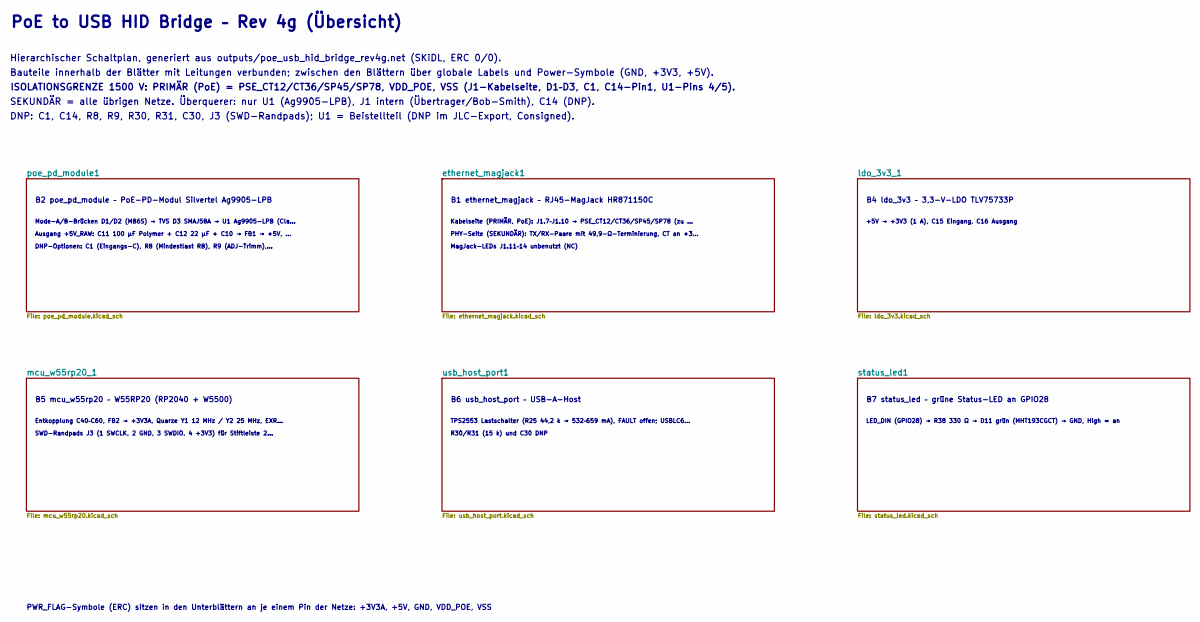
[picture p25: schematic poe_usb_hid_bridge_rev4g.kicad_sch, PoE to USB HID Bridge]

Notes on the sheet:
PoE to USB HID Bridge – Rev 4g (Übersicht)
Hierarchischer Schaltplan, generiert aus outputs/poe_usb_hid_bridge_rev4g.net (SKiDL, ERC 0/0).
Bauteile innerhalb der Blätter mit Leitungen verbunden; zwischen den Blättern über globale Labels und Power-Symbole (GND, +3V3, +5V).
ISOLATIONSGRENZE 1500 V: PRIMÄR (PoE) = PSE_CT12/CT36/SP45/SP78, VDD_POE, VSS (J1-Kabelseite, D1–D3, C1, C14-Pin1, U1-Pins 4/5).
SEKUNDÄR = alle übrigen Netze. Überquerer: nur U1 (Ag9905-LPB), J1 intern (Übertrager/Bob-Smith), C14 (DNP).
DNP: C1, C14, R8, R9, R30, R31, C30, J3 (SWD-Randpads); U1 = Beistellteil (DNP im JLC-Export, Consigned).
B2 poe_pd_module – PoE-PD-Modul Silvertel Ag9905-LPB
Mode-A/B-Brücken D1/D2 (MB6S) → TVS D3 SMAJ58A → U1 Ag9905-LPB (Cla…
Ausgang +5V_RAW: C11 100 µF Polymer + C12 22 µF + C10 → FB1 → +5V, …
DNP-Optionen: C1 (Eingangs-C), R8 (Mindestlast RB), R9 (ADJ-Trimm),…
B1 ethernet_magjack – RJ45-MagJack HR871150C
Kabelseite (PRIMÄR, PoE): J1.7–J1.10 → PSE_CT12/CT36/SP45/SP78 (zu …
PHY-Seite (SEKUNDÄR): TX/RX-Paare mit 49,9-Ω-Terminierung, CT an +3…
MagJack-LEDs J1.11–14 unbenutzt (NC)
B4 ldo_3v3 – 3,3-V-LDO TLV75733P
+5V → +3V3 (1 A), C15 Eingang, C16 Ausgang
B5 mcu_w55rp20 – W55RP20 (RP2040 + W5500)
Entkopplung C40–C60, FB2 → +3V3A, Quarze Y1 12 MHz / Y2 25 MHz, EXR…
SWD-Randpads J3 (1 SWCLK, 2 GND, 3 SWDIO, 4 +3V3) für Stiftleiste 2…
B6 usb_host_port – USB-A-Host
TPS2553 Lastschalter (R25 44,2 k → 532–659 mA), FAULT offen; USBLC6…
R30/R31 (15 k) und C30 DNP
B7 status_led – grüne Status-LED an GPIO28
LED_DIN (GPIO28) → R38 330 Ω → D11 grün (MHT193CGCT) → GND, High = an
PWR_FLAG-Symbole (ERC) sitzen in den Unterblättern an je einem Pin der Netze: +3V3A, +5V, GND, VDD_POE, VSS

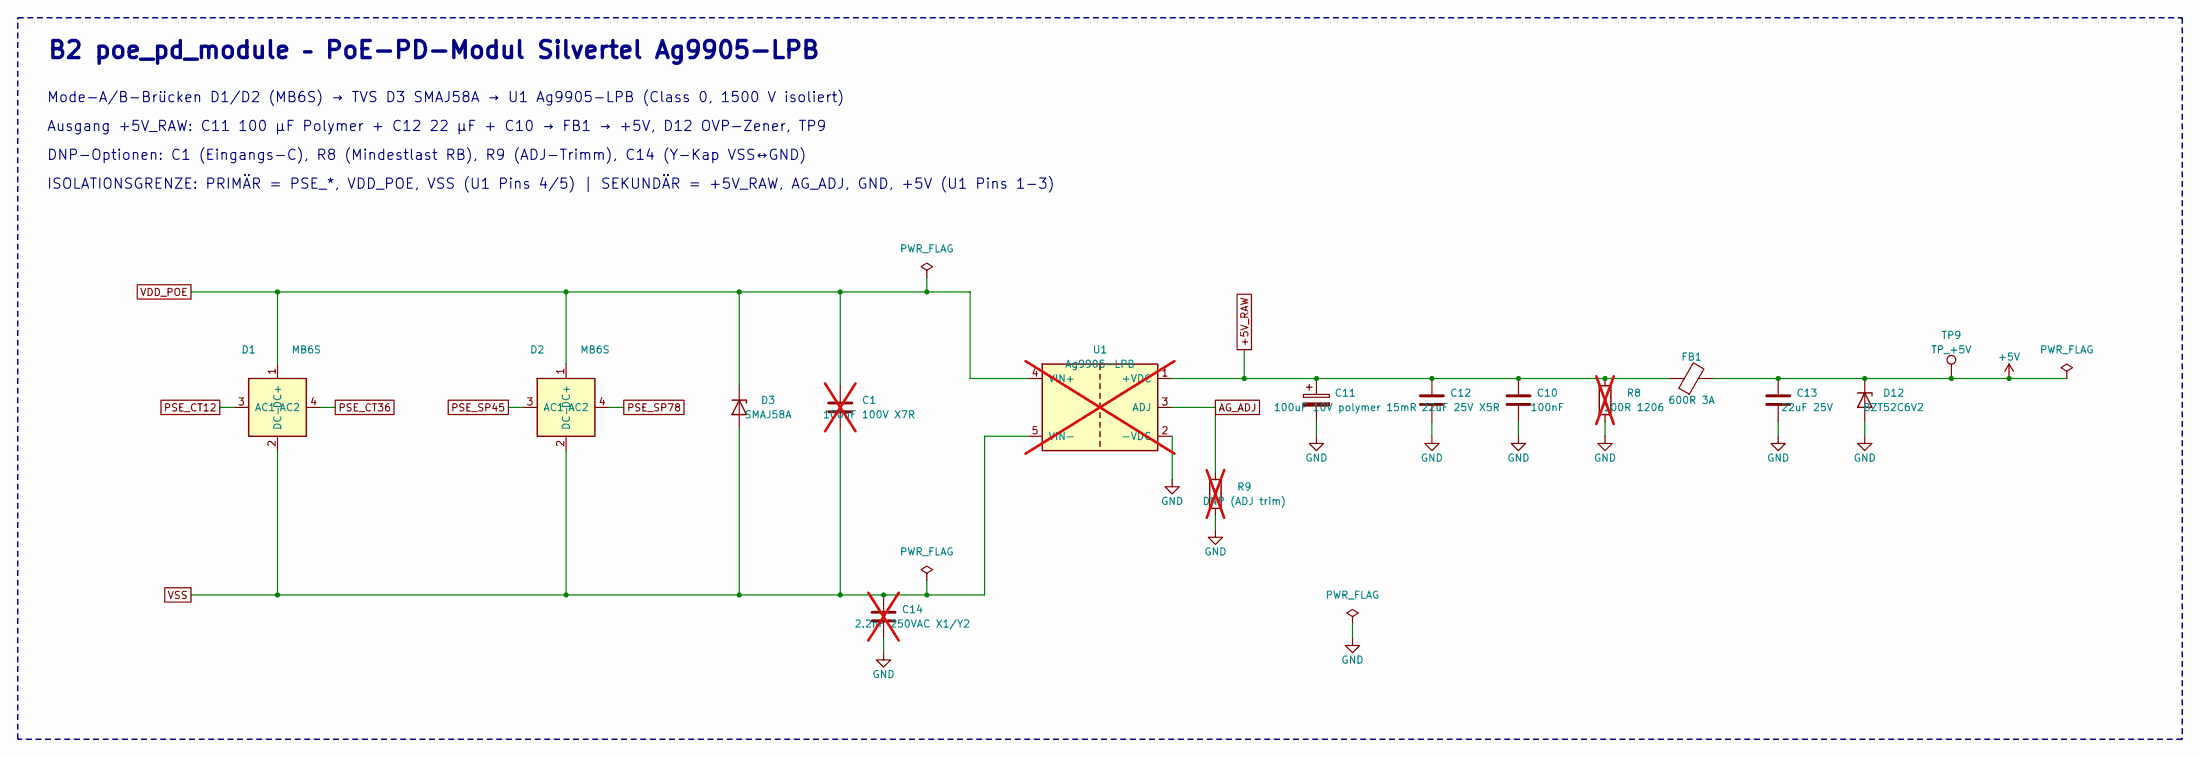
[picture p26: schematic poe_pd_module.kicad_sch, PoE to USB HID Bridge – B2 poe_pd_module – PoE-PD-Modul Sil…]

Parts:
C1: 100nF 100V X7R; C_0805_2012Metric; MPN CL21B104KCFNNNE; LCSC C28233; not fitted
C10: 100nF; C_0402_1005Metric; MPN CL05B104KO5NNNC; LCSC C1525
C11: 100uF 10V polymer 15mR; CP_EIA-7343-31_Kemet-D; MPN SA11AM101A19R15XXX; LCSC C135491
C12: 22uF 25V X5R; C_0805_2012Metric; MPN CL21A226MAQNNNE; LCSC C45783
C13: 22uF 25V; C_0805_2012Metric; MPN CL21A226MAQNNNE; LCSC C45783
C14: 2.2nF 250VAC X1/Y2; C_1812_4532Metric; MPN FK12X222K502EGQ; LCSC C53026446; not fitted
D1, D2: MB6S; TO-269AA; MPN MDD MB6S-50MIL; LCSC C2487
D3: SMAJ58A; D_SMA; MPN MDD SMAJ58A; LCSC C123816
D12: BZT52C6V2; D_SOD-123; MPN BZT52C6V2; LCSC C271260
FB1: 600R 3A; L_1206_3216Metric; MPN HCB3216KF-601T30; LCSC C357023
R8: 100R 1206; R_1206_3216Metric; MPN 1206W4F1000T5E; LCSC C17901; not fitted
R9: DNP (ADJ trim); R_0603_1608Metric; not fitted
TP9: TP_+5V; TestPoint_Pad_D1.0mm
U1: Ag9905-LPB; Silvertel_Ag9900LPB_SMD; MPN Ag9905-LPB; not fitted

Connections:
+5V: C13.1, D12.1 (K), FB1.2, TP9.1; also elsewhere on the board
+5V_RAW: C10.1, C11.1, C12.1, FB1.1, R8.1, U1.1 (+VDC)
AG_ADJ: R9.1, U1.3 (ADJ)
GND: C10.2, C11.2, C12.2, C13.2, C14.2, D12.2 (A), R8.2, R9.2, U1.2 (-VDC); also elsewhere on the board
PSE_CT12: D1.3 (AC1); also elsewhere on the board
PSE_CT36: D1.4 (AC2); also elsewhere on the board
PSE_SP45: D2.3 (AC1); also elsewhere on the board
PSE_SP78: D2.4 (AC2); also elsewhere on the board
VDD_POE: C1.1, D1.1 (DC+), D2.1 (DC+), D3.1 (K), U1.4 (VIN+)
VSS: C1.2, C14.1, D1.2 (DC-), D2.2 (DC-), D3.2 (A), U1.5 (VIN-)

Notes on the sheet:
B2 poe_pd_module – PoE-PD-Modul Silvertel Ag9905-LPB
Mode-A/B-Brücken D1/D2 (MB6S) → TVS D3 SMAJ58A → U1 Ag9905-LPB (Class 0, 1500 V isoliert)
Ausgang +5V_RAW: C11 100 µF Polymer + C12 22 µF + C10 → FB1 → +5V, D12 OVP-Zener, TP9
DNP-Optionen: C1 (Eingangs-C), R8 (Mindestlast RB), R9 (ADJ-Trimm), C14 (Y-Kap VSS↔GND)
ISOLATIONSGRENZE: PRIMÄR = PSE_*, VDD_POE, VSS (U1 Pins 4/5) | SEKUNDÄR = +5V_RAW, AG_ADJ, GND, +5V (U1 Pins 1-3)

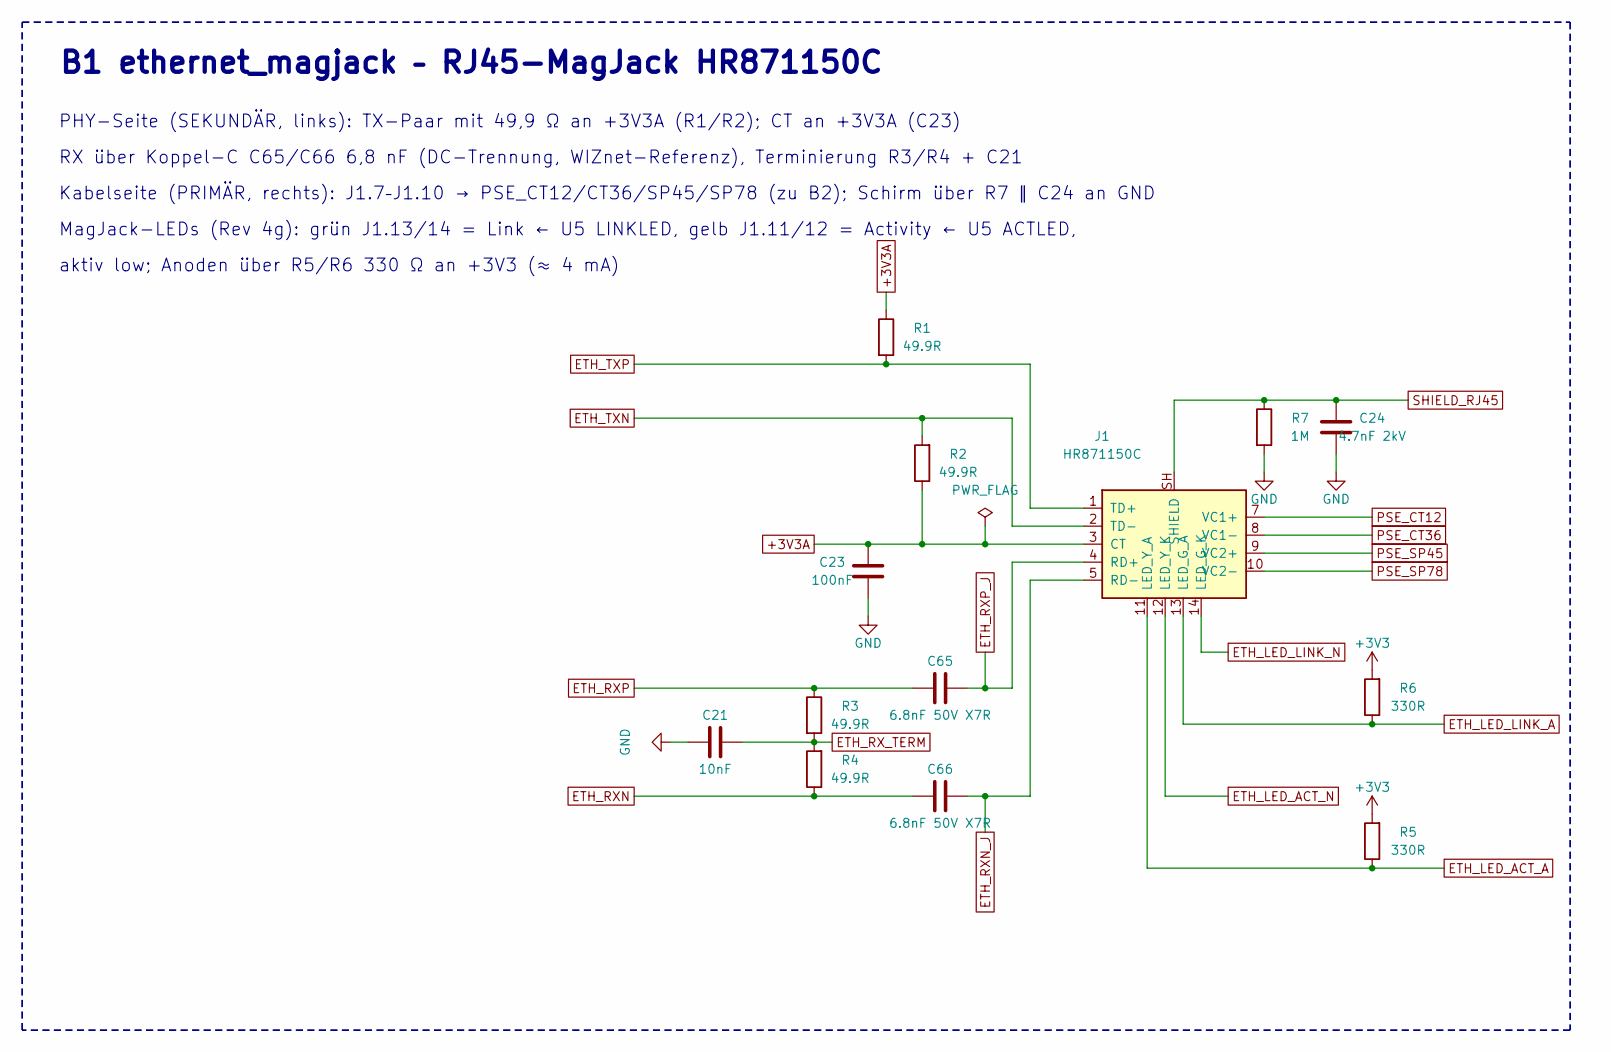
[picture p27: schematic ethernet_magjack.kicad_sch, PoE to USB HID Bridge – B1 ethernet_magjack – RJ45-MagJack …]

Parts:
C21: 10nF; C_0402_1005Metric; MPN CL05B103KB5NNNC; LCSC C15195
C23: 100nF; C_0402_1005Metric; MPN CL05B104KO5NNNC; LCSC C1525
C24: 4.7nF 2kV; C_1812_4532Metric; MPN C1812X472K202T; LCSC C106172
C65, C66: 6.8nF 50V X7R; C_0402_1005Metric; MPN YAGEO CC0402KRX7R9BB682; LCSC C93654
J1: HR871150C; HanRun_HR871150C; MPN HanRun HR871150C; LCSC C19724786
R1, R2, R3, R4: 49.9R; R_0402_1005Metric; MPN 0402WGF499JTCE; LCSC C25120
R5, R6: 330R; R_0402_1005Metric; MPN 0402WGF3300TCE; LCSC C25104
R7: 1M; R_0603_1608Metric; MPN 0603WAF1004T5E; LCSC C22935

Connections:
+3V3: R5.2, R6.2; also elsewhere on the board
+3V3A: C23.1, J1.3 (CT), R1.1, R2.1; also elsewhere on the board
ETH_LED_ACT_A: J1.11 (LED_Y_A), R5.1
ETH_LED_ACT_N: J1.12 (LED_Y_K); also elsewhere on the board
ETH_LED_LINK_A: J1.13 (LED_G_A), R6.1
ETH_LED_LINK_N: J1.14 (LED_G_K); also elsewhere on the board
ETH_RXN: C66.2, R4.1; also elsewhere on the board
ETH_RXN_J: C66.1, J1.5 (RD-)
ETH_RXP: C65.2, R3.1; also elsewhere on the board
ETH_RXP_J: C65.1, J1.4 (RD+)
ETH_RX_TERM: C21.1, R3.2, R4.2
ETH_TXN: J1.2 (TD-), R2.2; also elsewhere on the board
ETH_TXP: J1.1 (TD+), R1.2; also elsewhere on the board
GND: C21.2, C23.2, C24.2, R7.2; also elsewhere on the board
PSE_CT12: J1.7 (VC1+); also elsewhere on the board
PSE_CT36: J1.8 (VC1-); also elsewhere on the board
PSE_SP45: J1.9 (VC2+); also elsewhere on the board
PSE_SP78: J1.10 (VC2-); also elsewhere on the board
SHIELD_RJ45: C24.1, J1.SH (SHIELD), R7.1

Notes on the sheet:
B1 ethernet_magjack – RJ45-MagJack HR871150C
PHY-Seite (SEKUNDÄR, links): TX-Paar mit 49,9 Ω an +3V3A (R1/R2); CT an +3V3A (C23)
RX über Koppel-C C65/C66 6,8 nF (DC-Trennung, WIZnet-Referenz), Terminierung R3/R4 + C21
Kabelseite (PRIMÄR, rechts): J1.7–J1.10 → PSE_CT12/CT36/SP45/SP78 (zu B2); Schirm über R7 ∥ C24 an GND
MagJack-LEDs (Rev 4g): grün J1.13/14 = Link ← U5 LINKLED, gelb J1.11/12 = Activity ← U5 ACTLED,
aktiv low; Anoden über R5/R6 330 Ω an +3V3 (≈ 4 mA)

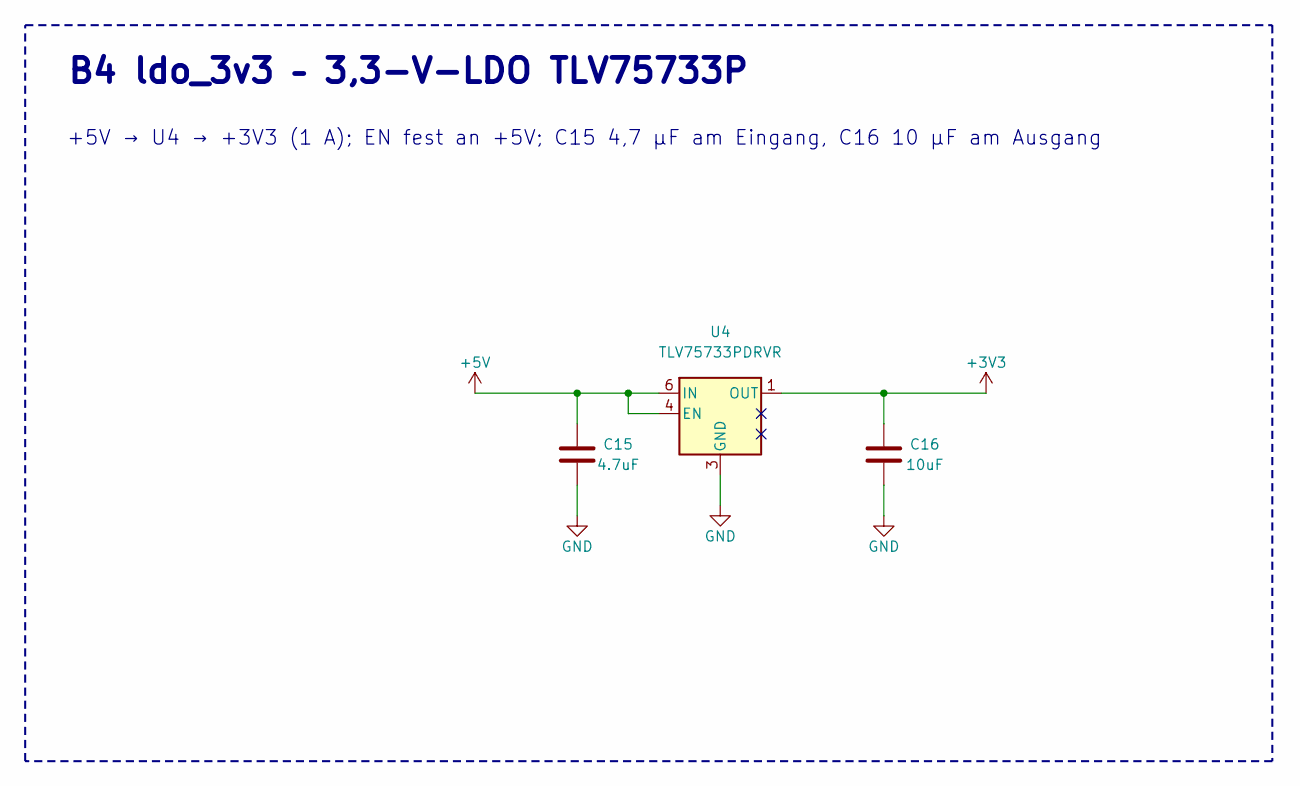
[picture p28: schematic ldo_3v3.kicad_sch, PoE to USB HID Bridge – B4 ldo_3v3 – 3,3-V-LDO TLV75733P]

Parts:
C15: 4.7uF; C_0603_1608Metric; MPN CL10A475KO8NNNC; LCSC C19666
C16: 10uF; C_0603_1608Metric; MPN CL10A106KP8NNNC; LCSC C19702
U4: TLV75733PDRVR; WSON-6-1EP_2x2mm_P0.65mm_EP1x1.6mm; MPN TLV75733PDRVR; LCSC C2868428

Connections:
+3V3: C16.1, U4.1 (OUT); also elsewhere on the board
+5V: C15.1, U4.4 (EN), U4.6 (IN); also elsewhere on the board
GND: C15.2, C16.2, U4.3 (GND), U4.7 (GND); also elsewhere on the board

Notes on the sheet:
B4 ldo_3v3 – 3,3-V-LDO TLV75733P
+5V → U4 → +3V3 (1 A); EN fest an +5V; C15 4,7 µF am Eingang, C16 10 µF am Ausgang

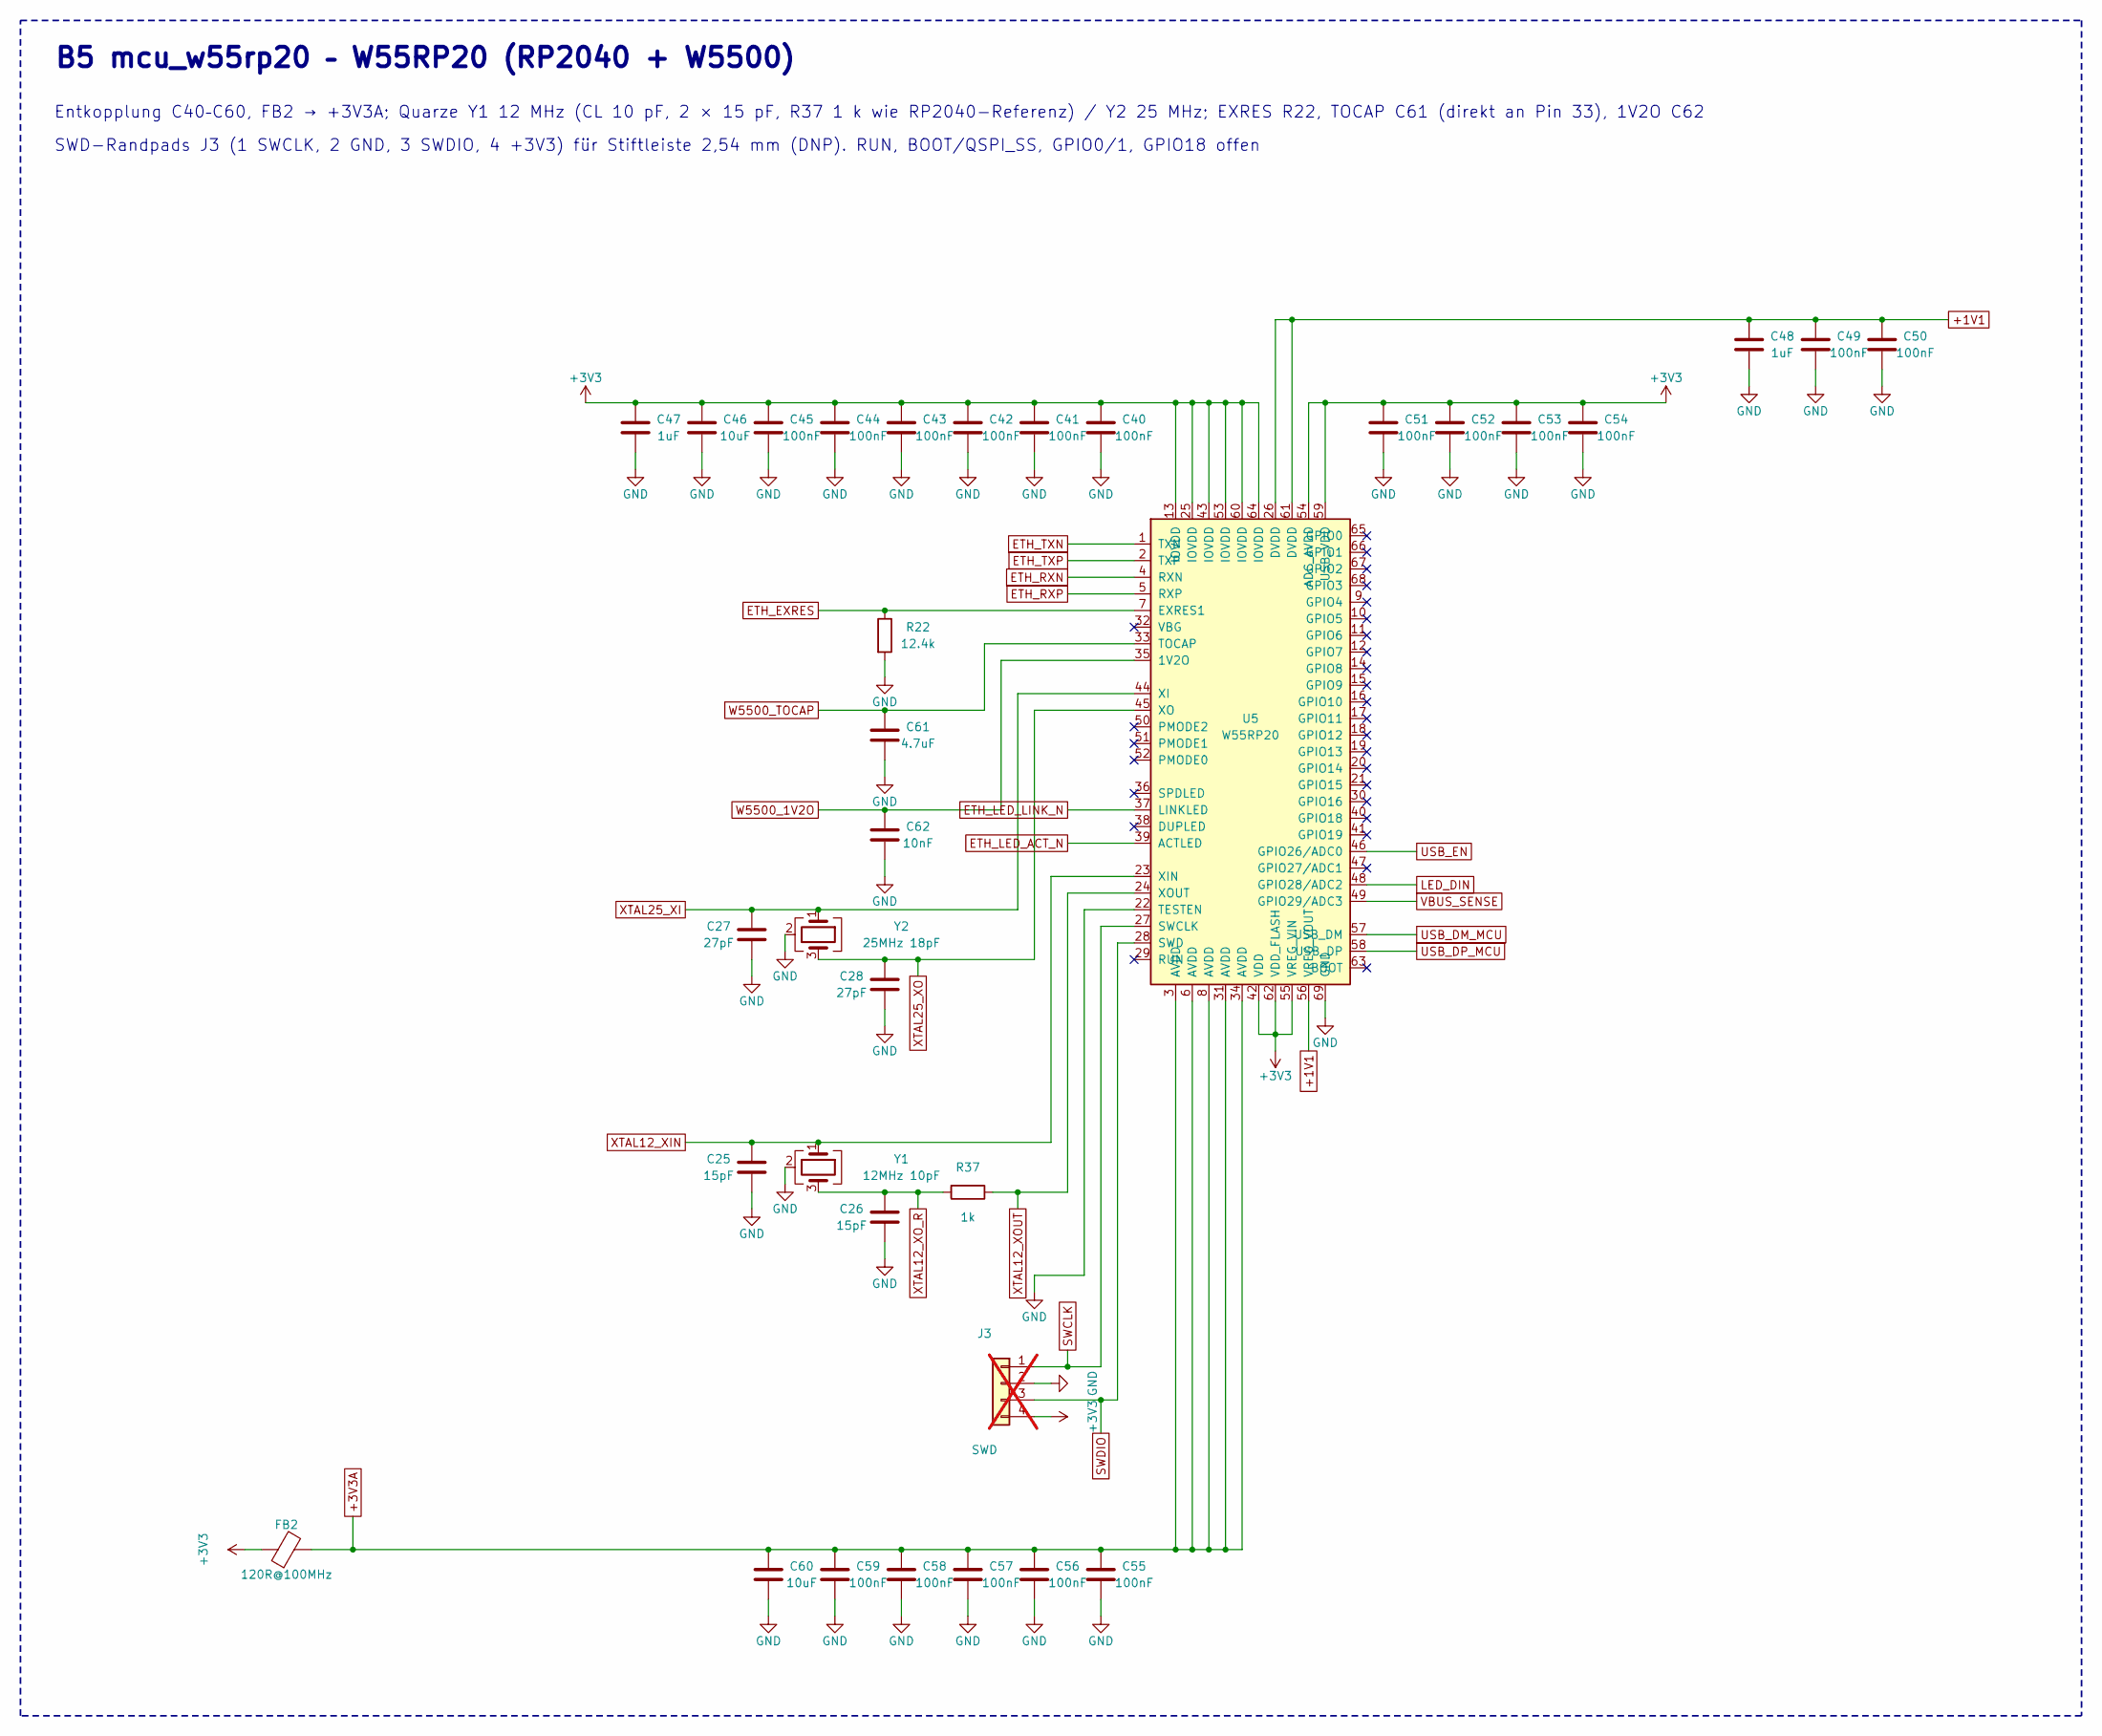
[picture p29: schematic mcu_w55rp20.kicad_sch, PoE to USB HID Bridge – B5 mcu_w55rp20 – W55RP20 (RP2040 + …]

Parts:
C25, C26: 15pF; C_0402_1005Metric; MPN 0402CG150J500NT; LCSC C1548
C27, C28: 27pF; C_0402_1005Metric; MPN 0402CG270J500NT; LCSC C1557
C40, C41, C42, C43, C44, C45, C49, C50, C51, C52, C53, C54, C55, C56, C57, C58, C59: 100nF; C_0402_1005Metric; MPN CL05B104KO5NNNC; LCSC C1525
C46, C60: 10uF; C_0603_1608Metric; MPN CL10A106KP8NNNC; LCSC C19702
C47, C48: 1uF; C_0402_1005Metric; MPN CL05A105KA5NQNC; LCSC C52923
C61: 4.7uF; C_0603_1608Metric; MPN CL10A475KO8NNNC; LCSC C19666
C62: 10nF; C_0402_1005Metric; MPN CL05B103KB5NNNC; LCSC C15195
FB2: 120R@100MHz; L_0603_1608Metric; MPN BLM18PG121SN1D; LCSC C14709
J3: SWD; SWD_Edge_1x04_P2.54mm_SMD; not fitted
R22: 12.4k; R_0402_1005Metric; MPN 0402WGF1242TCE; LCSC C11692
R37: 1k; R_0402_1005Metric; MPN 0402WGF1001TCE; LCSC C11702
U5: W55RP20; W55RP20_QFN-68-1EP_8x8mm_P0.4mm_EP6.2x6.2mm; MPN W55RP20; LCSC C43229502
Y1: 12MHz 10pF; Crystal_SMD_3225-4Pin_3.2x2.5mm; MPN Abracon ABM8-272-T3; LCSC C20625731
Y2: 25MHz 18pF; Crystal_SMD_3225-4Pin_3.2x2.5mm; MPN X322525MRB4SI; LCSC C70593

Connections:
+1V1: C48.1, C49.1, C50.1, U5.26 (DVDD), U5.56 (VREG_VOUT), U5.61 (DVDD)
+3V3: C40.1, C41.1, C42.1, C43.1, C44.1, C45.1, C46.1, C47.1, C51.1, C52.1, C53.1, C54.1, FB2.1, J3.4, U5.13 (IOVDD), U5.25 (IOVDD), U5.42 (VDD), U5.43 (IOVDD), U5.53 (IOVDD), U5.54 (ADC_AVDD), U5.55 (VREG_VIN), U5.59 (USB_VDD), U5.60 (IOVDD), U5.62 (VDD_FLASH), U5.64 (IOVDD); also elsewhere on the board
+3V3A: C55.1, C56.1, C57.1, C58.1, C59.1, C60.1, FB2.2, U5.3 (AVDD), U5.6 (AVDD), U5.8 (AVDD), U5.31 (AVDD), U5.34 (AVDD); also elsewhere on the board
ETH_EXRES: R22.1, U5.7 (EXRES1)
ETH_LED_ACT_N: U5.39 (ACTLED); also elsewhere on the board
ETH_LED_LINK_N: U5.37 (LINKLED); also elsewhere on the board
ETH_RXN: U5.4 (RXN); also elsewhere on the board
ETH_RXP: U5.5 (RXP); also elsewhere on the board
ETH_TXN: U5.1 (TXN); also elsewhere on the board
ETH_TXP: U5.2 (TXP); also elsewhere on the board
GND: C25.2, C26.2, C27.2, C28.2, C40.2, C41.2, C42.2, C43.2, C44.2, C45.2, C46.2, C47.2, C48.2, C49.2, C50.2, C51.2, C52.2, C53.2, C54.2, C55.2, C56.2, C57.2, C58.2, C59.2, C60.2, C61.2, C62.2, J3.2, R22.2, U5.22 (TESTEN), U5.69 (GND), Y1.2 (G), Y1.4 (G), Y2.2 (G), Y2.4 (G); also elsewhere on the board
LED_DIN: U5.48 (GPIO28/ADC2); also elsewhere on the board
SWCLK: J3.1, U5.27 (SWCLK)
SWDIO: J3.3, U5.28 (SWD)
USB_DM_MCU: U5.57 (USB_DM); also elsewhere on the board
USB_DP_MCU: U5.58 (USB_DP); also elsewhere on the board
USB_EN: U5.46 (GPIO26/ADC0); also elsewhere on the board
VBUS_SENSE: U5.49 (GPIO29/ADC3); also elsewhere on the board
W5500_1V2O: C62.1, U5.35 (1V2O)
W5500_TOCAP: C61.1, U5.33 (TOCAP)
XTAL12_XIN: C25.1, U5.23 (XIN), Y1.1
XTAL12_XOUT: R37.1, U5.24 (XOUT)
XTAL12_XO_R: C26.1, R37.2, Y1.3
XTAL25_XI: C27.1, U5.44 (XI), Y2.1
XTAL25_XO: C28.1, U5.45 (XO), Y2.3

Notes on the sheet:
B5 mcu_w55rp20 – W55RP20 (RP2040 + W5500)
Entkopplung C40–C60, FB2 → +3V3A; Quarze Y1 12 MHz (CL 10 pF, 2 × 15 pF, R37 1 k wie RP2040-Referenz) / Y2 25 MHz; EXRES R22, TOCAP C61 (direkt an Pin 33), 1V2O C62
SWD-Randpads J3 (1 SWCLK, 2 GND, 3 SWDIO, 4 +3V3) für Stiftleiste 2,54 mm (DNP). RUN, BOOT/QSPI_SS, GPIO0/1, GPIO18 offen

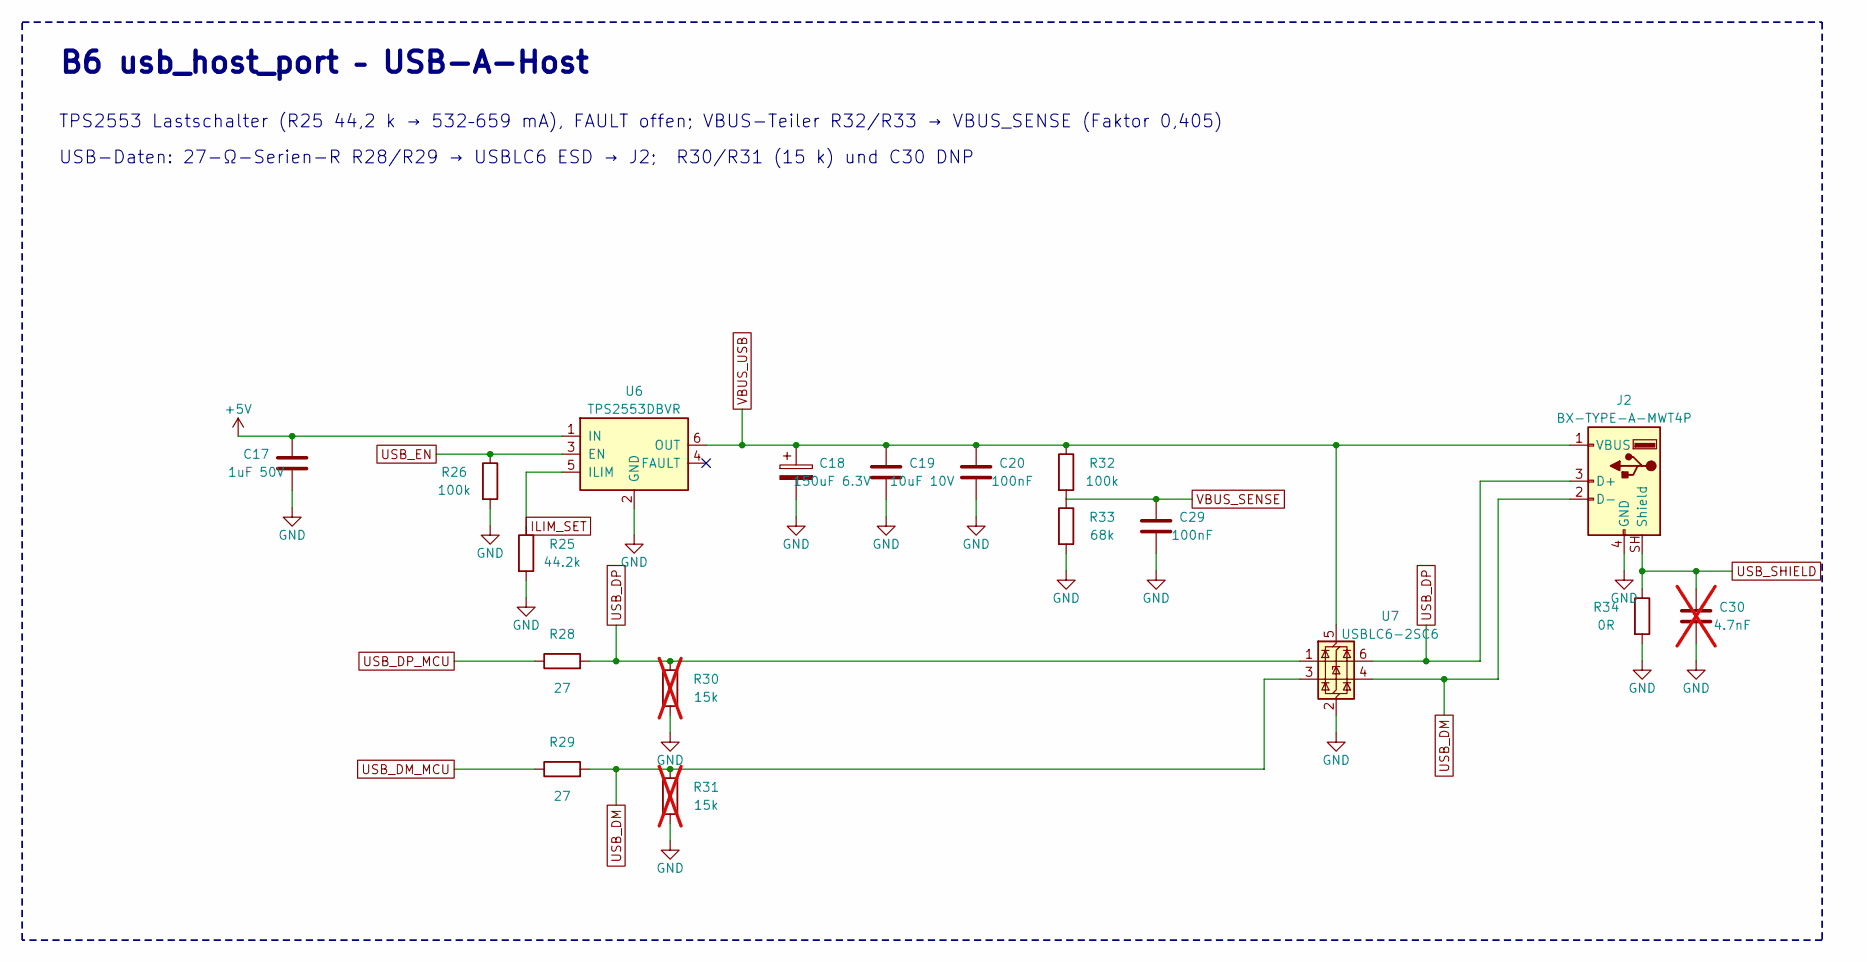
[picture p30: schematic usb_host_port.kicad_sch, PoE to USB HID Bridge – B6 usb_host_port – USB-A-Host]

Parts:
C17: 1uF 50V; C_0603_1608Metric; MPN CL10A105KB8NNNC; LCSC C15849
C18: 150uF 6.3V; CP_EIA-3528-21_Kemet-B; MPN T520B157M006ATE035; LCSC C212682
C19: 10uF 10V; C_0603_1608Metric; MPN CL10A106KP8NNNC; LCSC C19702
C20, C29: 100nF; C_0402_1005Metric; MPN CL05B104KO5NNNC; LCSC C1525
C30: 4.7nF; C_0603_1608Metric; MPN CL10B472KB8NNNC; LCSC C1621; not fitted
J2: BX-TYPE-A-MWT4P; MPN BX-TYPE-A-MWT4P; LCSC C18077687
R25: 44.2k; R_0402_1005Metric; MPN 0402WGF4422TCE; LCSC C25895
R26, R32: 100k; R_0402_1005Metric; MPN 0402WGF1003TCE; LCSC C25741
R28, R29: 27; R_0402_1005Metric; MPN 0402WGF270JTCE; LCSC C25100
R30, R31: 15k; R_0402_1005Metric; MPN 0402WGF1502TCE; LCSC C25756; not fitted
R33: 68k; R_0402_1005Metric; MPN 0402WGF6802TCE; LCSC C36871
R34: 0R; R_0603_1608Metric; MPN 0603WAF0000T5E; LCSC C21189
U6: TPS2553DBVR; SOT-23-6; MPN TPS2553DBVR; LCSC C55266
U7: USBLC6-2SC6; SOT-23-6; MPN USBLC6-2SC6; LCSC C7519

Connections:
+5V: C17.1, U6.1 (IN); also elsewhere on the board
GND: C17.2, C18.2, C19.2, C20.2, C29.2, C30.2, J2.4 (GND), R25.2, R26.2, R30.2, R31.2, R33.2, R34.2, U6.2 (GND), U7.2 (GND); also elsewhere on the board
ILIM_SET: R25.1, U6.5 (ILIM)
USB_DM: J2.2 (D-), R29.2, R31.1, U7.3 (I/O2), U7.4 (I/O2)
USB_DM_MCU: R29.1; also elsewhere on the board
USB_DP: J2.3 (D+), R28.2, R30.1, U7.1 (I/O1), U7.6 (I/O1)
USB_DP_MCU: R28.1; also elsewhere on the board
USB_EN: R26.1, U6.3 (EN); also elsewhere on the board
USB_SHIELD: C30.1, J2.SH (Shield), R34.1
VBUS_SENSE: C29.1, R32.2, R33.1; also elsewhere on the board
VBUS_USB: C18.1, C19.1, C20.1, J2.1 (VBUS), R32.1, U6.6 (OUT), U7.5 (VBUS)

Notes on the sheet:
B6 usb_host_port – USB-A-Host
TPS2553 Lastschalter (R25 44,2 k → 532–659 mA), FAULT offen; VBUS-Teiler R32/R33 → VBUS_SENSE (Faktor 0,405)
USB-Daten: 27-Ω-Serien-R R28/R29 → USBLC6 ESD → J2; R30/R31 (15 k) und C30 DNP

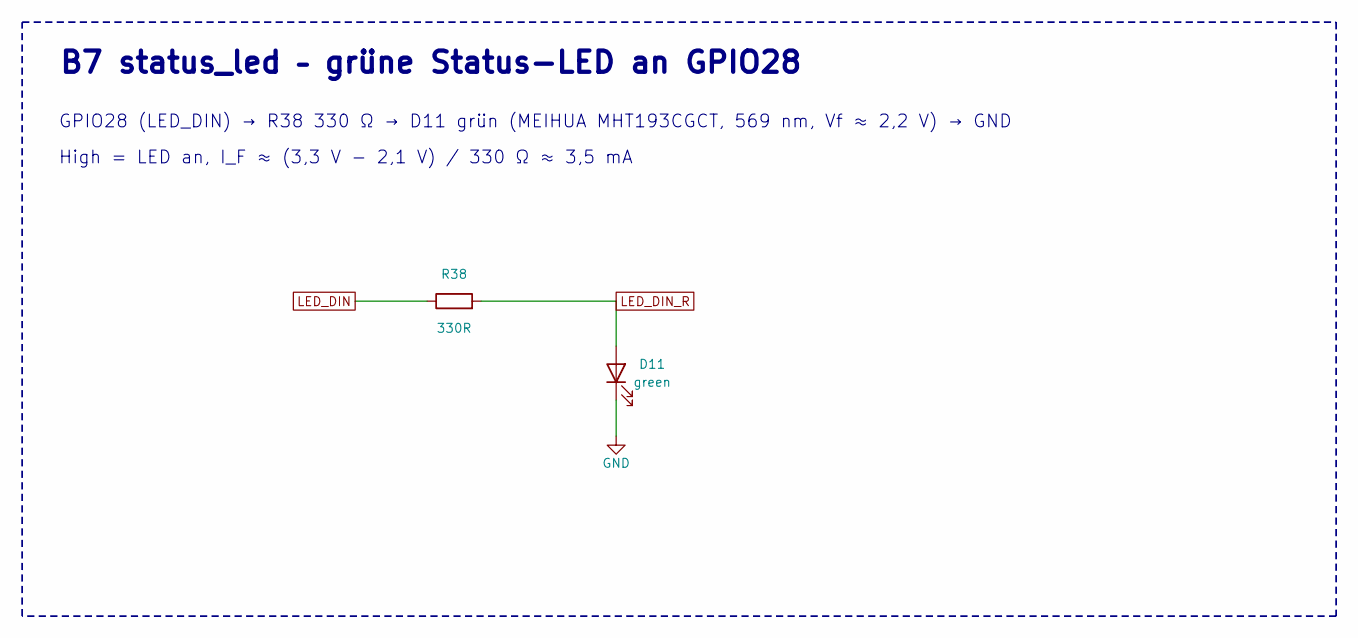
[picture p31: schematic status_led.kicad_sch, PoE to USB HID Bridge – B7 status_led – grüne Status-LED]

Parts:
D11: green; LED_0603_1608Metric; MPN MEIHUA MHT193CGCT; LCSC C2962098
R38: 330R; R_0402_1005Metric; MPN 0402WGF3300TCE; LCSC C25104

Connections:
GND: D11.1 (K); also elsewhere on the board
LED_DIN: R38.1; also elsewhere on the board
LED_DIN_R: D11.2 (A), R38.2

Notes on the sheet:
B7 status_led – grüne Status-LED an GPIO28
GPIO28 (LED_DIN) → R38 330 Ω → D11 grün (MEIHUA MHT193CGCT, 569 nm, Vf ≈ 2,2 V) → GND
High = LED an, I_F ≈ (3,3 V − 2,1 V) / 330 Ω ≈ 3,5 mA

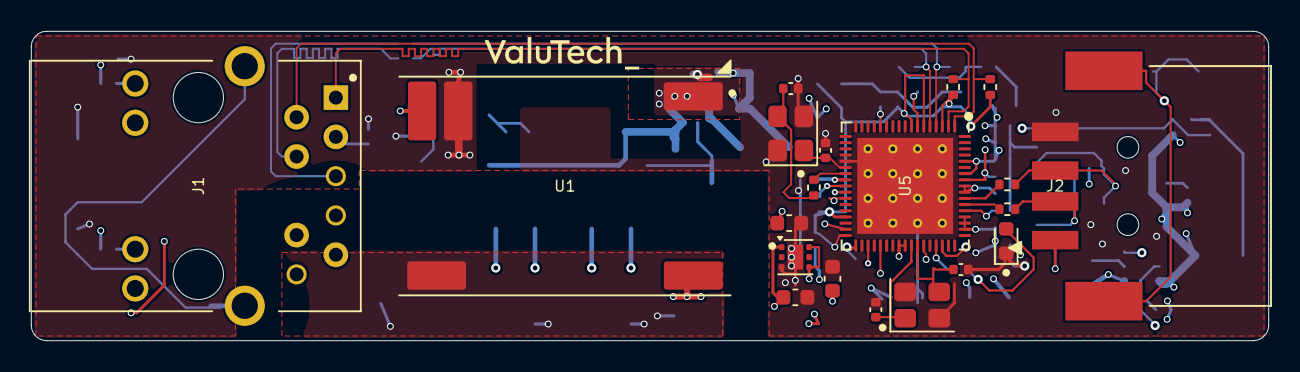
[picture p32: board poe_usb_hid_bridge_rev4g.kicad_pcb from above]

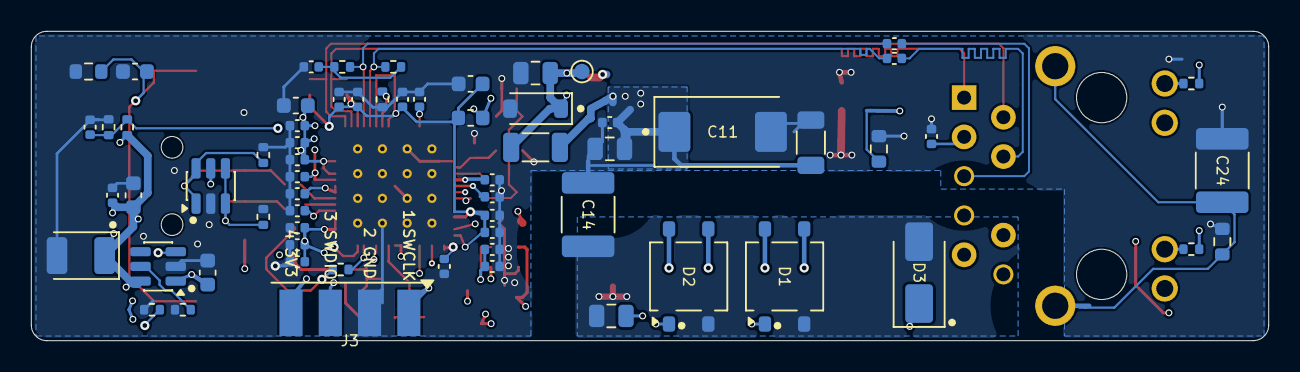
[picture p33: board poe_usb_hid_bridge_rev4g.kicad_pcb from below]

Board: 6 copper layers, 80.0 x 20.0 mm, 86 parts (65 on the bottom side), 46 nets.

Other parts of the board:
G1: Logo_ValuTech_10mm
