sire234/VatPoeToUsb/circuits/__main___sklib.py

from collections import defaultdict
from skidl import Pin, Part, Alias, SchLib, SKIDL, TEMPLATE

from skidl.pin import pin_types

SKIDL_lib_version = '0.0.1'

__main__ = SchLib(tool=SKIDL).add_parts(*[
        Part(**{ 'name':'HR871150C', 'dest':TEMPLATE, 'tool':SKIDL, 'aliases':Alias({'HR871150C'}), 'ref_prefix':'J', 'fplist':['poe_usb_hid_bridge:HanRun_HR871150C'], 'footprint':'poe_usb_hid_bridge:HanRun_HR871150C', 'keywords':'RJ45 magjack PoE 10/100 HanRun', 'description':"HanRun HR871150C RJ45 MagJack 10/100 PoE (4 center taps), 2 LEDs, THT. No pin 6. CT(P3) = ONE common chip-side center tap of both transformers. Shield pad 'SH' (2 tabs).", 'datasheet':'https://datasheet.lcsc.com/datasheet/pdf/bae28869af3176e6a10bdf4859b444a5.pdf', 'pins':[
            Pin(num='1',name='TD+',func=pin_types.PASSIVE,unit=1),
            Pin(num='2',name='TD-',func=pin_types.PASSIVE,unit=1),
            Pin(num='3',name='CT',func=pin_types.PASSIVE,unit=1),
            Pin(num='4',name='RD+',func=pin_types.PASSIVE,unit=1),
            Pin(num='5',name='RD-',func=pin_types.PASSIVE,unit=1),
            Pin(num='7',name='VC1+',func=pin_types.PASSIVE,unit=1),
            Pin(num='8',name='VC1-',func=pin_types.PASSIVE,unit=1),
            Pin(num='9',name='VC2+',func=pin_types.PASSIVE,unit=1),
            Pin(num='10',name='VC2-',func=pin_types.PASSIVE,unit=1),
            Pin(num='SH',name='SHIELD',func=pin_types.PASSIVE,unit=1),
            Pin(num='11',name='LED_Y_A',func=pin_types.PASSIVE,unit=1),
            Pin(num='12',name='LED_Y_K',func=pin_types.PASSIVE,unit=1),
            Pin(num='13',name='LED_G_A',func=pin_types.PASSIVE,unit=1),
            Pin(num='14',name='LED_G_K',func=pin_types.PASSIVE,unit=1)], 'unit_defs':[] }),
        Part(**{ 'name':'R', 'dest':TEMPLATE, 'tool':SKIDL, 'aliases':Alias({'R'}), 'ref_prefix':'R', 'fplist':[''], 'footprint':'Resistor_SMD:R_0402_1005Metric', 'keywords':'R res resistor', 'description':'Resistor', 'datasheet':'', 'pins':[
            Pin(num='1',func=pin_types.PASSIVE,unit=1),
            Pin(num='2',func=pin_types.PASSIVE,unit=1)], 'unit_defs':[] }),
        Part(**{ 'name':'C', 'dest':TEMPLATE, 'tool':SKIDL, 'aliases':Alias({'C'}), 'ref_prefix':'C', 'fplist':[''], 'footprint':'Capacitor_SMD:C_0402_1005Metric', 'keywords':'cap capacitor', 'description':'Unpolarized capacitor', 'datasheet':'', 'pins':[
            Pin(num='1',func=pin_types.PASSIVE,unit=1),
            Pin(num='2',func=pin_types.PASSIVE,unit=1)], 'unit_defs':[] }),
        Part(**{ 'name':'MB6S_MDD', 'dest':TEMPLATE, 'tool':SKIDL, 'aliases':Alias({'MB6S_MDD'}), 'ref_prefix':'D', 'fplist':['Package_TO_SOT_SMD:TO-269AA'], 'footprint':'Package_TO_SOT_SMD:TO-269AA', 'keywords':'bridge rectifier MB6S MDD', 'description':'MDD MB6S bridge rectifier MBS/TO-269AA. MDD datasheet pinout: 1=+ 2=- 3=~ 4=~ (KiCad Diode_Bridge:MB6S has 3=+ 4=-, do not use)', 'datasheet':'https://www.microdiode.com/', 'pins':[
            Pin(num='3',name='AC1',func=pin_types.PASSIVE,unit=1),
            Pin(num='4',name='AC2',func=pin_types.PASSIVE,unit=1),
            Pin(num='1',name='DC+',func=pin_types.PASSIVE,unit=1),
            Pin(num='2',name='DC-',func=pin_types.PASSIVE,unit=1)], 'unit_defs':[] }),
        Part(**{ 'name':'D_Zener', 'dest':TEMPLATE, 'tool':SKIDL, 'aliases':Alias({'D_Zener'}), 'ref_prefix':'D', 'fplist':[''], 'footprint':'Diode_SMD:D_SMA', 'keywords':'diode', 'description':'Zener diode', 'datasheet':'', 'pins':[
            Pin(num='1',name='K',func=pin_types.PASSIVE,unit=1),
            Pin(num='2',name='A',func=pin_types.PASSIVE,unit=1)], 'unit_defs':[] }),
        Part(**{ 'name':'Ag9905-LPB', 'dest':TEMPLATE, 'tool':SKIDL, 'aliases':Alias({'Ag9905-LPB'}), 'ref_prefix':'U', 'fplist':['poe_usb_hid_bridge:Silvertel_Ag9900LPB_SMD'], 'footprint':'poe_usb_hid_bridge:Silvertel_Ag9900LPB_SMD', 'keywords':'PoE PD module Silvertel Ag9900 LPB isolated DC-DC SMT', 'description':'Silvertel Ag9905-LPB IEEE802.3af PoE PD module, Class 0, 5.0 V (4.75-5.25) / 1.4 A, 7 W @70C / 4.5 W @85C (industrial), 1500 V isolated, low-profile SMT 21.21x13.92x8.0 mm (max 9.2). Pins (DS V3.5 Table 2): 1 +VDC, 2 -VDC, 3 ADJ (open = 5.0 V), 4 VIN+, 5 VIN-. Min load 200 mA, C_out >= 100 uF low-ESR.', 'datasheet':'https://silvertel.com/images/datasheets/Ag9900M-datasheet-ultra-miniature-isolated-Power-over-Ethernet-POE-module.pdf', 'pins':[
            Pin(num='4',name='VIN+',func=pin_types.PWRIN,unit=1),
            Pin(num='5',name='VIN-',func=pin_types.PWRIN,unit=1),
            Pin(num='1',name='+VDC',func=pin_types.PWROUT,unit=1),
            Pin(num='2',name='-VDC',func=pin_types.PASSIVE,unit=1),
            Pin(num='3',name='ADJ',func=pin_types.PASSIVE,unit=1)], 'unit_defs':[] }),
        Part(**{ 'name':'C_Polarized', 'dest':TEMPLATE, 'tool':SKIDL, 'aliases':Alias({'C_Polarized'}), 'ref_prefix':'C', 'fplist':[''], 'footprint':'Capacitor_Tantalum_SMD:CP_EIA-7343-31_Kemet-D', 'keywords':'cap capacitor', 'description':'Polarized capacitor', 'datasheet':'', 'pins':[
            Pin(num='1',func=pin_types.PASSIVE,unit=1),
            Pin(num='2',func=pin_types.PASSIVE,unit=1)], 'unit_defs':[] }),
        Part(**{ 'name':'FerriteBead', 'dest':TEMPLATE, 'tool':SKIDL, 'aliases':Alias({'FerriteBead'}), 'ref_prefix':'FB', 'fplist':[''], 'footprint':'Inductor_SMD:L_1206_3216Metric', 'keywords':'L ferrite bead inductor filter', 'description':'Ferrite bead', 'datasheet':'', 'pins':[
            Pin(num='1',func=pin_types.PASSIVE,unit=1),
            Pin(num='2',func=pin_types.PASSIVE,unit=1)], 'unit_defs':[] }),
        Part(**{ 'name':'TestPoint', 'dest':TEMPLATE, 'tool':SKIDL, 'aliases':Alias({'TestPoint'}), 'ref_prefix':'TP', 'fplist':[''], 'footprint':'TestPoint:TestPoint_Pad_D1.0mm', 'keywords':'test point tp', 'description':'test point', 'datasheet':'', 'pins':[
            Pin(num='1',name='1',func=pin_types.PASSIVE,unit=1)], 'unit_defs':[] }),
        Part(**{ 'name':'TLV75733PDRV', 'dest':TEMPLATE, 'tool':SKIDL, 'aliases':Alias({'TLV75733PDRV'}), 'ref_prefix':'U', 'fplist':['Package_SON:WSON-6-1EP_2x2mm_P0.65mm_EP1x1.6mm', 'Package_SON:WSON-6-1EP_2x2mm_P0.65mm_EP1x1.6mm'], 'footprint':'Package_SON:WSON-6-1EP_2x2mm_P0.65mm_EP1x1.6mm', 'keywords':'LDO Regulator Fixed Positive', 'description':'1A Low IQ Small Size Low Dropout Voltage Regulator, Fixed Output 3.3V, WSON6', 'datasheet':'https://www.ti.com/lit/ds/symlink/tlv757p.pdf', 'pins':[
            Pin(num='1',name='OUT',func=pin_types.PWROUT,unit=1),
            Pin(num='2',name='NC',func=pin_types.NOCONNECT,unit=1),
            Pin(num='3',name='GND',func=pin_types.PWRIN,unit=1),
            Pin(num='4',name='EN',func=pin_types.INPUT,unit=1),
            Pin(num='5',name='NC',func=pin_types.NOCONNECT,unit=1),
            Pin(num='6',name='IN',func=pin_types.PWRIN,unit=1),
            Pin(num='7',name='GND',func=pin_types.PASSIVE,unit=1)], 'unit_defs':[] }),
        Part(**{ 'name':'W55RP20', 'dest':TEMPLATE, 'tool':SKIDL, 'aliases':Alias({'W55RP20'}), 'ref_prefix':'U', 'fplist':['poe_usb_hid_bridge:W55RP20_QFN-68-1EP_8x8mm_P0.4mm_EP6.2x6.2mm'], 'footprint':'poe_usb_hid_bridge:W55RP20_QFN-68-1EP_8x8mm_P0.4mm_EP6.2x6.2mm', 'keywords':'W55RP20 RP2040 W5500 ethernet SiP', 'description':'WIZnet W55RP20 SiP (RP2040 + W5500 + 2MB flash), QFN-68 8x8 P0.4 + EP (pin 69 = GND). Pin map verified vs W55RP20 DS V1.0.0. Pin 62 (flash VDD) is named VDD_FLASH.', 'datasheet':'https://docs.wiznet.io/Product/Chip/MCU/W55RP20', 'pins':[
            Pin(num='1',name='TXN',func=pin_types.OUTPUT,unit=1),
            Pin(num='2',name='TXP',func=pin_types.OUTPUT,unit=1),
            Pin(num='4',name='RXN',func=pin_types.INPUT,unit=1),
            Pin(num='5',name='RXP',func=pin_types.INPUT,unit=1),
            Pin(num='7',name='EXRES1',func=pin_types.PASSIVE,unit=1),
            Pin(num='32',name='VBG',func=pin_types.PASSIVE,unit=1),
            Pin(num='33',name='TOCAP',func=pin_types.PASSIVE,unit=1),
            Pin(num='35',name='1V2O',func=pin_types.PASSIVE,unit=1),
            Pin(num='44',name='XI',func=pin_types.INPUT,unit=1),
            Pin(num='45',name='XO',func=pin_types.OUTPUT,unit=1),
            Pin(num='50',name='PMODE2',func=pin_types.INPUT,unit=1),
            Pin(num='51',name='PMODE1',func=pin_types.INPUT,unit=1),
            Pin(num='52',name='PMODE0',func=pin_types.INPUT,unit=1),
            Pin(num='36',name='SPDLED',func=pin_types.OUTPUT,unit=1),
            Pin(num='37',name='LINKLED',func=pin_types.OUTPUT,unit=1),
            Pin(num='38',name='DUPLED',func=pin_types.OUTPUT,unit=1),
            Pin(num='39',name='ACTLED',func=pin_types.OUTPUT,unit=1),
            Pin(num='23',name='XIN',func=pin_types.INPUT,unit=1),
            Pin(num='24',name='XOUT',func=pin_types.OUTPUT,unit=1),
            Pin(num='22',name='TESTEN',func=pin_types.INPUT,unit=1),
            Pin(num='27',name='SWCLK',func=pin_types.INPUT,unit=1),
            Pin(num='28',name='SWD',func=pin_types.BIDIR,unit=1),
            Pin(num='29',name='RUN',func=pin_types.INPUT,unit=1),
            Pin(num='65',name='GPIO0',func=pin_types.BIDIR,unit=1),
            Pin(num='66',name='GPIO1',func=pin_types.BIDIR,unit=1),
            Pin(num='67',name='GPIO2',func=pin_types.BIDIR,unit=1),
            Pin(num='68',name='GPIO3',func=pin_types.BIDIR,unit=1),
            Pin(num='9',name='GPIO4',func=pin_types.BIDIR,unit=1),
            Pin(num='10',name='GPIO5',func=pin_types.BIDIR,unit=1),
            Pin(num='11',name='GPIO6',func=pin_types.BIDIR,unit=1),
            Pin(num='12',name='GPIO7',func=pin_types.BIDIR,unit=1),
            Pin(num='14',name='GPIO8',func=pin_types.BIDIR,unit=1),
            Pin(num='15',name='GPIO9',func=pin_types.BIDIR,unit=1),
            Pin(num='16',name='GPIO10',func=pin_types.BIDIR,unit=1),
            Pin(num='17',name='GPIO11',func=pin_types.BIDIR,unit=1),
            Pin(num='18',name='GPIO12',func=pin_types.BIDIR,unit=1),
            Pin(num='19',name='GPIO13',func=pin_types.BIDIR,unit=1),
            Pin(num='20',name='GPIO14',func=pin_types.BIDIR,unit=1),
            Pin(num='21',name='GPIO15',func=pin_types.BIDIR,unit=1),
            Pin(num='30',name='GPIO16',func=pin_types.BIDIR,unit=1),
            Pin(num='40',name='GPIO18',func=pin_types.BIDIR,unit=1),
            Pin(num='41',name='GPIO19',func=pin_types.BIDIR,unit=1),
            Pin(num='46',name='GPIO26/ADC0',func=pin_types.BIDIR,unit=1),
            Pin(num='47',name='GPIO27/ADC1',func=pin_types.BIDIR,unit=1),
            Pin(num='48',name='GPIO28/ADC2',func=pin_types.BIDIR,unit=1),
            Pin(num='49',name='GPIO29/ADC3',func=pin_types.BIDIR,unit=1),
            Pin(num='57',name='USB_DM',func=pin_types.BIDIR,unit=1),
            Pin(num='58',name='USB_DP',func=pin_types.BIDIR,unit=1),
            Pin(num='63',name='BOOT',func=pin_types.BIDIR,unit=1),
            Pin(num='13',name='IOVDD',func=pin_types.PWRIN,unit=1),
            Pin(num='25',name='IOVDD',func=pin_types.PWRIN,unit=1),
            Pin(num='43',name='IOVDD',func=pin_types.PWRIN,unit=1),
            Pin(num='53',name='IOVDD',func=pin_types.PWRIN,unit=1),
            Pin(num='60',name='IOVDD',func=pin_types.PWRIN,unit=1),
            Pin(num='64',name='IOVDD',func=pin_types.PWRIN,unit=1),
            Pin(num='26',name='DVDD',func=pin_types.PWRIN,unit=1),
            Pin(num='61',name='DVDD',func=pin_types.PWRIN,unit=1),
            Pin(num='54',name='ADC_AVDD',func=pin_types.PWRIN,unit=1),
            Pin(num='59',name='USB_VDD',func=pin_types.PWRIN,unit=1),
            Pin(num='3',name='AVDD',func=pin_types.PWRIN,unit=1),
            Pin(num='6',name='AVDD',func=pin_types.PWRIN,unit=1),
            Pin(num='8',name='AVDD',func=pin_types.PWRIN,unit=1),
            Pin(num='31',name='AVDD',func=pin_types.PWRIN,unit=1),
            Pin(num='34',name='AVDD',func=pin_types.PWRIN,unit=1),
            Pin(num='42',name='VDD',func=pin_types.PWRIN,unit=1),
            Pin(num='62',name='VDD_FLASH',func=pin_types.PWRIN,unit=1),
            Pin(num='55',name='VREG_VIN',func=pin_types.PWRIN,unit=1),
            Pin(num='56',name='VREG_VOUT',func=pin_types.PWROUT,unit=1),
            Pin(num='69',name='GND',func=pin_types.PWRIN,unit=1)], 'unit_defs':[] }),
        Part(**{ 'name':'Crystal_GND24', 'dest':TEMPLATE, 'tool':SKIDL, 'aliases':Alias({'Crystal_GND24'}), 'ref_prefix':'Y', 'fplist':[''], 'footprint':'Crystal:Crystal_SMD_3225-4Pin_3.2x2.5mm', 'keywords':'quartz ceramic resonator oscillator', 'description':'Four pin crystal, GND on pins 2 and 4', 'datasheet':'', 'pins':[
            Pin(num='1',name='1',func=pin_types.PASSIVE,unit=1),
            Pin(num='2',name='G',func=pin_types.PASSIVE,unit=1),
            Pin(num='3',name='3',func=pin_types.PASSIVE,unit=1),
            Pin(num='4',name='G',func=pin_types.PASSIVE,unit=1)], 'unit_defs':[] }),
        Part(**{ 'name':'Conn_01x04', 'dest':TEMPLATE, 'tool':SKIDL, 'aliases':Alias({'Conn_01x04'}), 'ref_prefix':'J', 'fplist':[''], 'footprint':'poe_usb_hid_bridge:SWD_Edge_1x04_P2.54mm_SMD', 'keywords':'connector', 'description':'Generic connector, single row, 01x04, script generated (kicad-library-utils/schlib/autogen/connector/)', 'datasheet':'', 'pins':[
            Pin(num='1',name='Pin_1',func=pin_types.PASSIVE,unit=1),
            Pin(num='2',name='Pin_2',func=pin_types.PASSIVE,unit=1),
            Pin(num='3',name='Pin_3',func=pin_types.PASSIVE,unit=1),
            Pin(num='4',name='Pin_4',func=pin_types.PASSIVE,unit=1)], 'unit_defs':[] }),
        Part(**{ 'name':'TPS2553', 'dest':TEMPLATE, 'tool':SKIDL, 'aliases':Alias({'TPS2553'}), 'ref_prefix':'U', 'fplist':['Package_TO_SOT_SMD:SOT-23-6'], 'footprint':'Package_TO_SOT_SMD:SOT-23-6', 'keywords':'USB power switch load switch current limit', 'description':'TI precision adjustable current-limit power switch 1.5 A, EN active high, SOT-23-6 (DBV). 1=IN 2=GND 3=EN 4=FAULT(OD) 5=ILIM 6=OUT', 'datasheet':'https://www.ti.com/lit/ds/symlink/tps2553.pdf', 'pins':[
            Pin(num='1',name='IN',func=pin_types.PWRIN,unit=1),
            Pin(num='3',name='EN',func=pin_types.INPUT,unit=1),
            Pin(num='5',name='ILIM',func=pin_types.PASSIVE,unit=1),
            Pin(num='6',name='OUT',func=pin_types.PWROUT,unit=1),
            Pin(num='4',name='FAULT',func=pin_types.OPENCOLL,unit=1),
            Pin(num='2',name='GND',func=pin_types.PWRIN,unit=1)], 'unit_defs':[] }),
        Part(**{ 'name':'USBLC6-2SC6', 'dest':TEMPLATE, 'tool':SKIDL, 'aliases':Alias({'USBLC6-2SC6'}), 'ref_prefix':'U', 'fplist':['Package_TO_SOT_SMD:SOT-666', 'Package_TO_SOT_SMD:SOT-23-6'], 'footprint':'Package_TO_SOT_SMD:SOT-23-6', 'keywords':'usb ethernet video', 'description':'Very low capacitance ESD protection diode, 2 data-line, SOT-23-6', 'datasheet':'https://www.st.com/resource/en/datasheet/usblc6-2.pdf', 'pins':[
            Pin(num='1',name='I/O1',func=pin_types.PASSIVE,unit=1),
            Pin(num='2',name='GND',func=pin_types.PASSIVE,unit=1),
            Pin(num='3',name='I/O2',func=pin_types.PASSIVE,unit=1),
            Pin(num='4',name='I/O2',func=pin_types.PASSIVE,unit=1),
            Pin(num='5',name='VBUS',func=pin_types.PASSIVE,unit=1),
            Pin(num='6',name='I/O1',func=pin_types.PASSIVE,unit=1)], 'unit_defs':[] }),
        Part(**{ 'name':'USB_A', 'dest':TEMPLATE, 'tool':SKIDL, 'aliases':Alias({'USB_A'}), 'ref_prefix':'J', 'fplist':[''], 'footprint':'poe_usb_hid_bridge:BX-TYPE-A-MWT4P', 'keywords':'connector USB', 'description':'USB Type A connector', 'datasheet':'', 'pins':[
            Pin(num='1',name='VBUS',func=pin_types.PWRIN,unit=1),
            Pin(num='2',name='D-',func=pin_types.BIDIR,unit=1),
            Pin(num='3',name='D+',func=pin_types.BIDIR,unit=1),
            Pin(num='4',name='GND',func=pin_types.PWRIN,unit=1),
            Pin(num='SH',name='Shield',func=pin_types.PASSIVE,unit=1)], 'unit_defs':[] }),
        Part(**{ 'name':'LED', 'dest':TEMPLATE, 'tool':SKIDL, 'aliases':Alias({'LED'}), 'ref_prefix':'D', 'fplist':[''], 'footprint':'LED_SMD:LED_0603_1608Metric', 'keywords':'LED diode', 'description':'Light emitting diode', 'datasheet':'', 'pins':[
            Pin(num='1',name='K',func=pin_types.PASSIVE,unit=1),
            Pin(num='2',name='A',func=pin_types.PASSIVE,unit=1)], 'unit_defs':[] })])
