sire234/VatPoeToUsb/firmware/src/app.h

// Interfaces between the firmware modules (all run in the main loop, no RTOS, no second core)
#ifndef APP_H
#define APP_H

#include <stdbool.h>
#include <stddef.h>
#include <stdint.h>

// ---- main.c ----
// HID data / events: to the TCP client (net.c)
void app_emit(const char *s, size_t len);
void app_eventf(const char *fmt, ...) __attribute__((format(printf, 1, 2)));
size_t app_status(char *buf, size_t size);

// ---- debug_log.c: copy of every printf line (with uptime) in a ring buffer, readable over TCP ----
void debug_log_init(void);
uint32_t debug_log_oldest(void);
uint32_t debug_log_newest(void);
bool debug_log_read(uint32_t *cursor, char *buf, size_t size);

// ---- led.c: status LED D11 ----
typedef enum {
    LED_BOOT,       // on: starting
    LED_NO_LINK,    // short flash every second: no Ethernet link
    LED_NO_IP,      // 4 Hz: link up, waiting for DHCP
    LED_READY,      // on, flickers off on HID activity
    LED_USB_FAULT,  // 3 flashes, pause: USB port switched off (overload)
} led_mode_t;

void led_init(void);
void led_set_mode(led_mode_t mode);
void led_activity(void);
void led_task(void);

// ---- usb_port.c: VBUS switch (TPS2553) and overload detection ----
void usb_port_init(void);
void usb_port_set(bool on);
void usb_port_task(void);
bool usb_port_is_on(void);
bool usb_port_fault(void);
float usb_port_vbus(void);

// ---- hid_app.c: TinyUSB HID host callbacks only ----

// ---- valve.c: VAT valves (272b:0010), text commands over the vendor HID interface ----
bool valve_is_valve(uint8_t dev_addr);
void valve_mount(uint8_t dev_addr, uint8_t idx);
void valve_unmount(uint8_t dev_addr);
bool valve_report(uint8_t dev_addr, const uint8_t *report, uint16_t len);
void valve_request(uint8_t dev_addr, char kind, const char *cmd);   // kind 'V', 'T' or 'C', see valve.c
size_t valve_list(char *buf, size_t size);
void valve_task(void);

// ---- w5500_pio_spi.c: W5500 inside the W55RP20 ----
void w5500_pio_spi_init(void);
void w5500_hw_reset(void);

// ---- net.c: link, DHCP, TCP server ----
typedef enum { NET_NO_CHIP, NET_NO_LINK, NET_DHCP, NET_READY } net_state_t;

void net_init(void);
void net_task(void);
net_state_t net_state(void);
void net_queue(const char *s, size_t len);
bool net_queue_fits(size_t len);        // true if len bytes fit into the TCP send buffer now
void net_ip_string(char *buf, size_t size);

// ---- mdns.c: poe-hid-xxxxxx.local + DNS-SD _poehid._tcp ----
void mdns_start(uint8_t sn);
void mdns_stop(void);
void mdns_announce(void);
void mdns_task(void);
const char *mdns_hostname(void);
void mdns_stats(uint32_t *rx, uint32_t *answered, uint32_t *legacy);   // packets received / answered / ignored

#endif
