sire234/VatPoeToUsb/(commit log)

2026-10-26 Initial commit: PoE-to-USB HID bridge design (rev4g)
    [A1_deckel_flach.stl, A1_deckel_kopfueber.stl, A1_eckig_druckplatte.3mf, A1_gehaeuse_druckplatte.3mf, A1_rohr_stehend.stl, A1_wanne.stl, deckel.stl, ethernet_magjack.kicad_sch]
2026-10-27 Add example firmware (TinyUSB host, W5500, mDNS) and enclosure lengthwise stop
    - firmware/: Pico SDK 2.3.1 + TinyUSB host (hub, HID, MSC/FatFs log),
    W5500 via PIO-SPI, DHCP with static fallback, TCP server on port 5000,
    mDNS/DNS-SD responder (poe-hid-xxxxxx.local, _poehid._tcp), VBUS
    overload supervision, status LED, RTT debug output
    - Square enclosure: snap lips now sit in short pockets instead of a
    continuous groove, so the cover can no longer slide lengthwise;
    exports, renders and README updated
    - .gitignore: firmware/build; VS Code: compile_commands.json for IntelliSense
    [A1_eckig_druckplatte.3mf, A1_wanne.stl, gehaeuse_eckig.3mf, gehaeuse_eckig.step]
2026-10-28 Strengthen enclosure snap fit: deeper undercut, 30° retaining flank
    Bump now reaches 0.35 mm into the wall with a 45° lead-in and a 30°
    retaining flank; tray pockets shortened/deepened so the pocket top edge
    sits on the retaining flank and pulls the snapped cover down.
    [A1_deckel_kopfueber.stl, A1_eckig_druckplatte.3mf, A1_wanne.stl, gehaeuse_eckig.3mf, gehaeuse_eckig.step]
2026-10-30 Enclosure: full-width plinth, corner locating blocks, explicit snap lips on both sides
    - Plinth widened to the tray width (flush long sides, no print overhang)
    - Snap lips modelled per side; solid.mirror had dropped the -y bumps
    - 4 locating blocks in the cover's inner corners stop lengthwise and sideways play
    - Regenerated STL/3MF/STEP exports and views
    [A1_deckel_kopfueber.stl, A1_eckig_druckplatte.3mf, A1_wanne.stl, gehaeuse_eckig.3mf, gehaeuse_eckig.step]
2026-11-11 Add bring-up firmware: blinky and hardware self-test
    blinky: D11 at 2 Hz plus an RTT counter, first flash test via SWD.
    hwtest: checks clocks (XOSC/sys/usb), QSPI flash (JEDEC ID, size,
    erase/write/verify of the last sector), ADC/temperature, the USB port
    switch with VBUS sense, and the W5500 (version, register R/W at 3.9 and
    15.6 MHz, INTn, PHY link). Results as PASS/FAIL over RTT. Passed on the
    first rev4g board, powered from the debug Pico's VBUS at TP9.
    Flash with a Raspberry Pi Pico running debugprobe + probe-rs:
    probe-rs run --chip RP2040 build/hwtest.elf
    [main.c]
2026-11-11 Firmware: VAT valve access over TCP, two hubs, drop mass storage
    - valve.c: VAT valves (272b:0010) via their vendor HID interface.
    Packet format of the legacy CPA (8-byte header, code 0x15, text + CR LF,
    64-byte padded reports), long replies reassembled from 0x7A continuation
    reports, 1 s timeout, one request at a time. Allow-list: read services,
    g:1E17..1E21 and the two W1 writes only; everything else is blocked.
    TCP commands "valves" and "v<addr> <command>", reply "#V<addr> <text>".
    - tusb_config.h: CFG_TUH_HUB 2, 8 devices. 7-port hubs are two cascaded
    hubs; with one hub address the second hub hit an assert and enumeration
    stopped for good.
    - Mass storage removed (CFG_TUH_MS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
2026-11-11 Add valve-scan: find bridges via mDNS and read VAT valve parameters
    Single-file .NET 10 console tool (win-x64, self-contained, trimmed).
    Browses _poehid._tcp.local with a small built-in mDNS client (query from
    port 5353, the firmware ignores other source ports), connects to each
    bridge on TCP 5000, lists the valves ("valves") and reads serial number,
    firmware, series, control/access mode, error number/code, warnings,
    positions and pressure. Sends the W1 hex-format writes first, like the
    legacy CPA on connect; otherwise read commands only.
    valve-scan browse via mDNS
    valve-scan <ip> use this bridge directly
2026-11-12 Firmware: debug log over TCP, mDNS and valve diagnostics
    - debug_log.c: extra stdio driver, every printf line (with uptime) also
    goes into a 4 KB ring buffer. TCP "log" sends the history ("#LOG ...",
    "#LOG end"), "debug on"/"debug off" streams new lines ("#DBG ...").
    Off on every new connection. RTT output unchanged.
    - mDNS: logs queries for our names (sender, names/types, answered or
    ignored for a source port other than 5353), announcements and send
    errors; counters in #STATUS as mdns=<received>/<answered>/<ignored>.
    - Valves: logs each request (uid, interrupt OUT or SET_REPORT), each
    reply (bytes, reports, ms), blocked/busy, timeouts with progress,
    stale/unexpected reports.
    -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
    [app.h, debug_log.c, main.c, mdns.c, net.c, valve.c]
2026-11-12 valve-scan: --verbose with firmware log, mDNS retries, endurance test
    - --verbose / -v: mDNS interfaces, queries and answers, every TCP line,
    plus the bridge's debug history (FW-LOG) and live output (FW).
    - mDNS query repeated after 0 / 0.5 / 1 / 2 s and missing SRV/A asked for:
    the first multicast answer is often lost on WLAN (seen in the verbose
    log: bridge answered, PC never got it). Receive errors are skipped.
    - --endurance [--duration s]: reads all parameters of all valves in a loop,
    the full tree (g:1E18, ~98 KB / 56 parts) every 50 rounds; checks static
    values and the tree hash; status every 5 s, summary, exit code 0/2.
    60 s run on two valves: 6036/6036 OK, 0 mismatches.
    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
2026-11-12 Enclosure variant with SWD header opening; remove superseded versions
    - make_script.py --swd: rectangular enclosure with a notch in the -y wall
    for the SWD header J3 (laid flat on the edge pads), open to the seam so
    the board goes in with the header soldered; cover tongue closes it above
    the header body; rear -y snap lip moved to x 66-76. 0.6 mm play to the
    header, 0.25 mm tongue play (corner blocks locate the cover). Interference
    check: 0 collisions. Standard variant unchanged (same volumes).
    Output in mechanical/gehaeuse_eckig_rev1_swd/.
    - Removed (still in git history): round enclosures rev1/rev2, PCB revisions
    4b/4e/4f with their outputs, fab_rev4g_final (drill offset; vali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
    [A1_deckel_flach.stl, A1_deckel_kopfueber.stl, A1_eckig_druckplatte.3mf, A1_gehaeuse_druckplatte.3mf, A1_rohr_stehend.stl, A1_wanne.stl, deckel.stl, ethernet_magjack.kicad_sch]
2026-11-13 Firmware: reset the W5500 PHY when no link comes up; add architecture overview
    Without a link for 5 s the PHY is reset, every third attempt the whole chip.
    Guards against the PHY not starting auto-negotiation at PoE power-up.
    ARCHITEKTUR.md: plain-language overview of the firmware with mermaid diagrams.
    [net.c]
2026-11-13 Firmware: text command with tick (t) and controller type (c) for cpa4showcase
    - t<addr> <cmd> returns the valve tick with the reply.
    - c<addr> reads the controller type (message 0x16).
    - The allow-list also accepts the change-counter acks and W2 0x06102000 (0/1),
    the same as the showcase gate.
